Philz69/3ITPCB/Power.xlsx

Part | Max current (mA) | Power draw | Qty | Total Current (mA)
ADS1118 | 0.3 |  | 8 | 2.4
INA250 | 0.3 |  | 18 | 5.4
ADC124S021 | 2.1 |  | 5 | 10.5
LM358 | 2 |  | 5 | 10
 |  |  | Total: | 28.3
