Philz69/3ITPCB/PCB.kicad_pcb

## KiCad design PCB.kicad_pcb (2020-07-17)

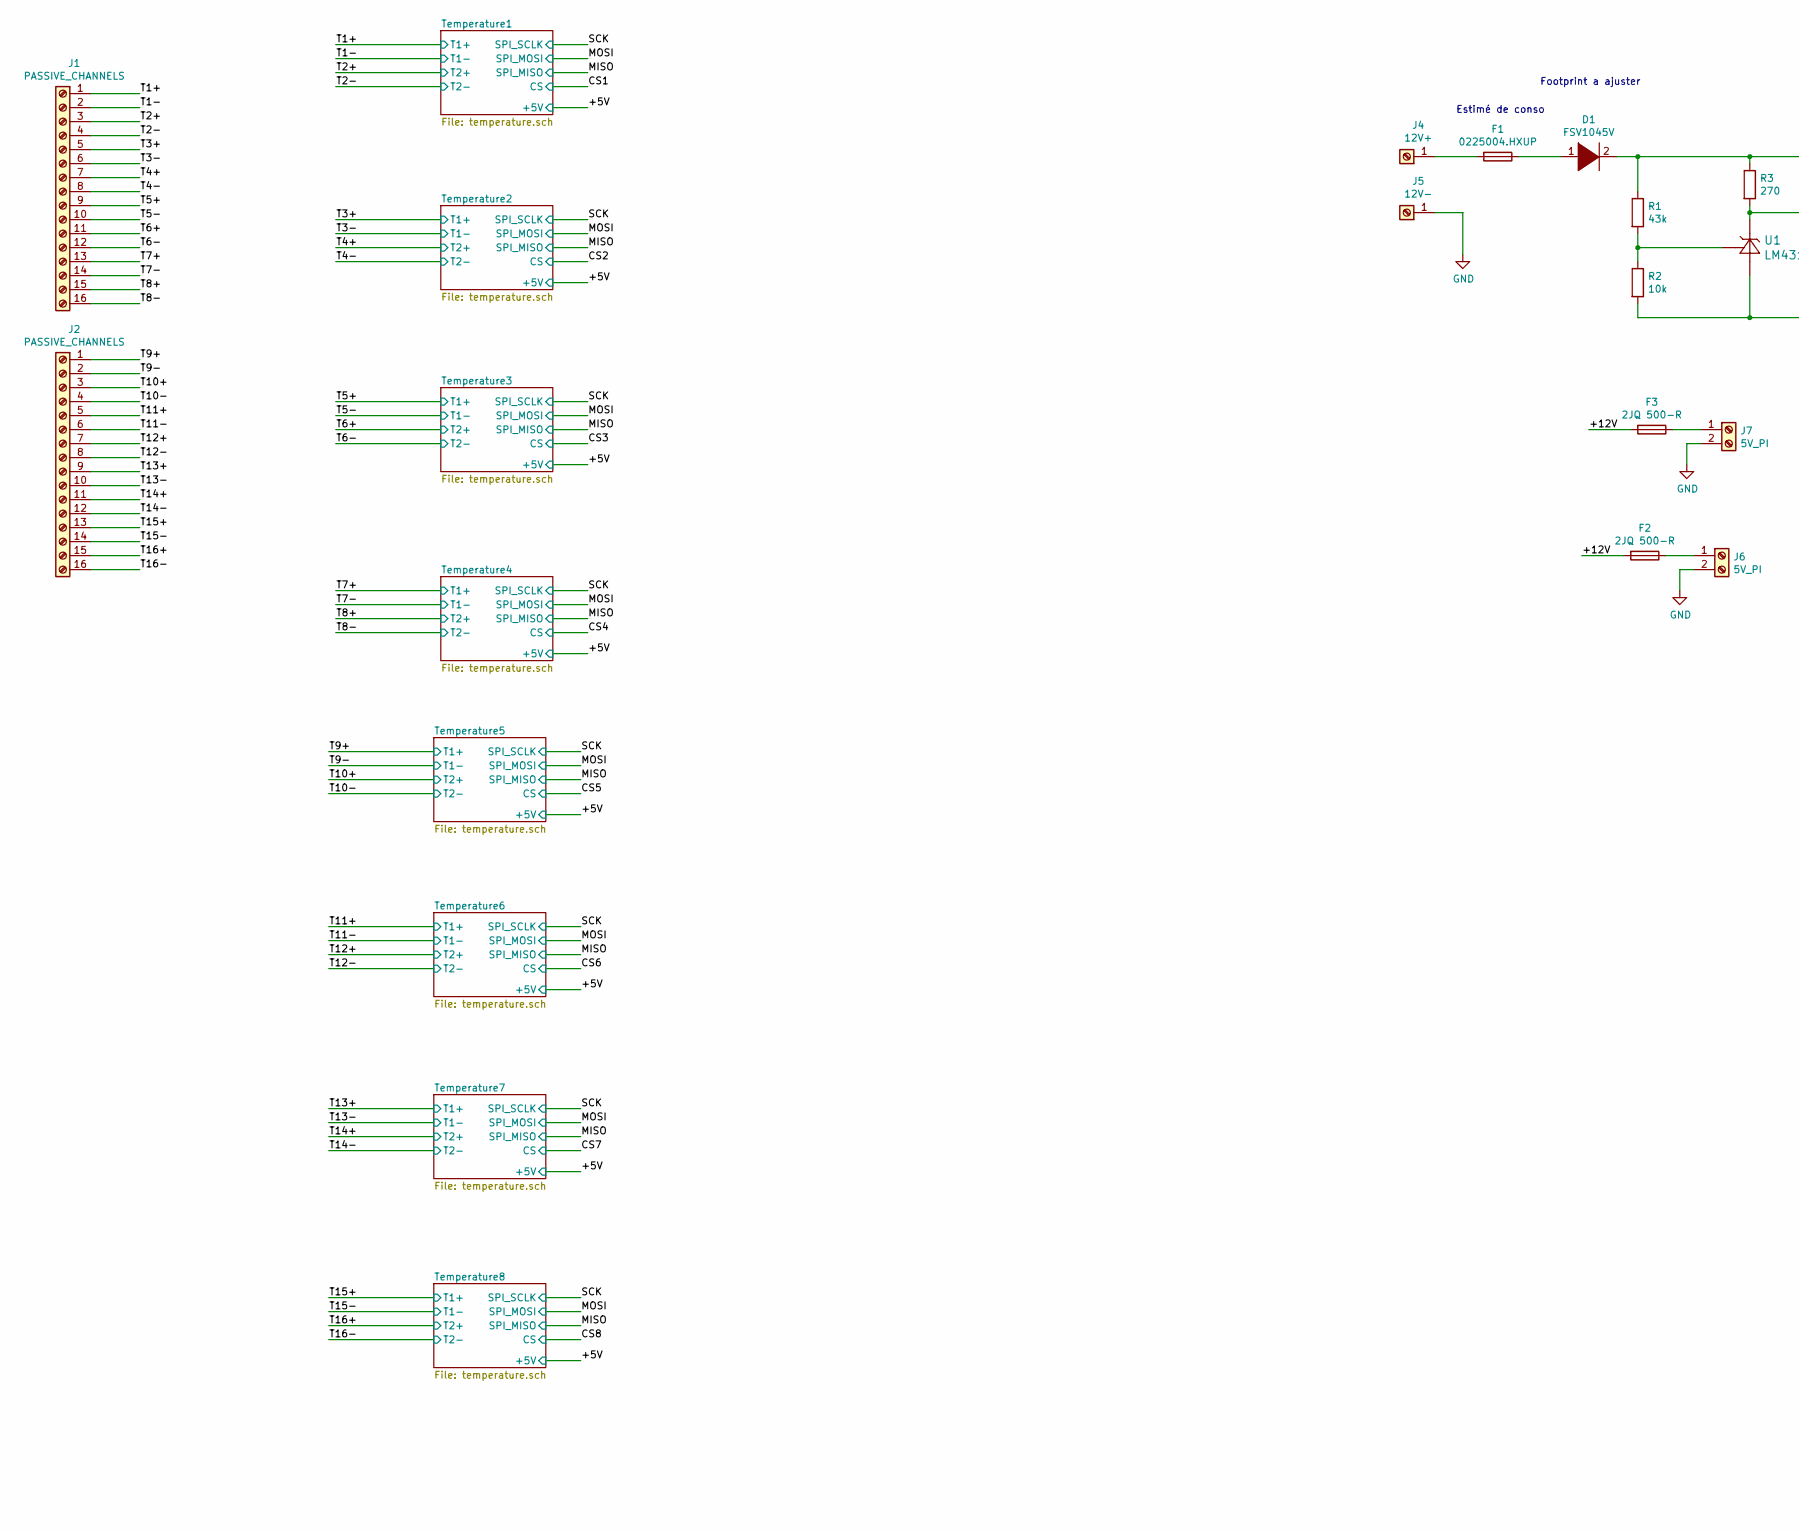
[picture p1: schematic PCB.sch, part in row 1, column 1]

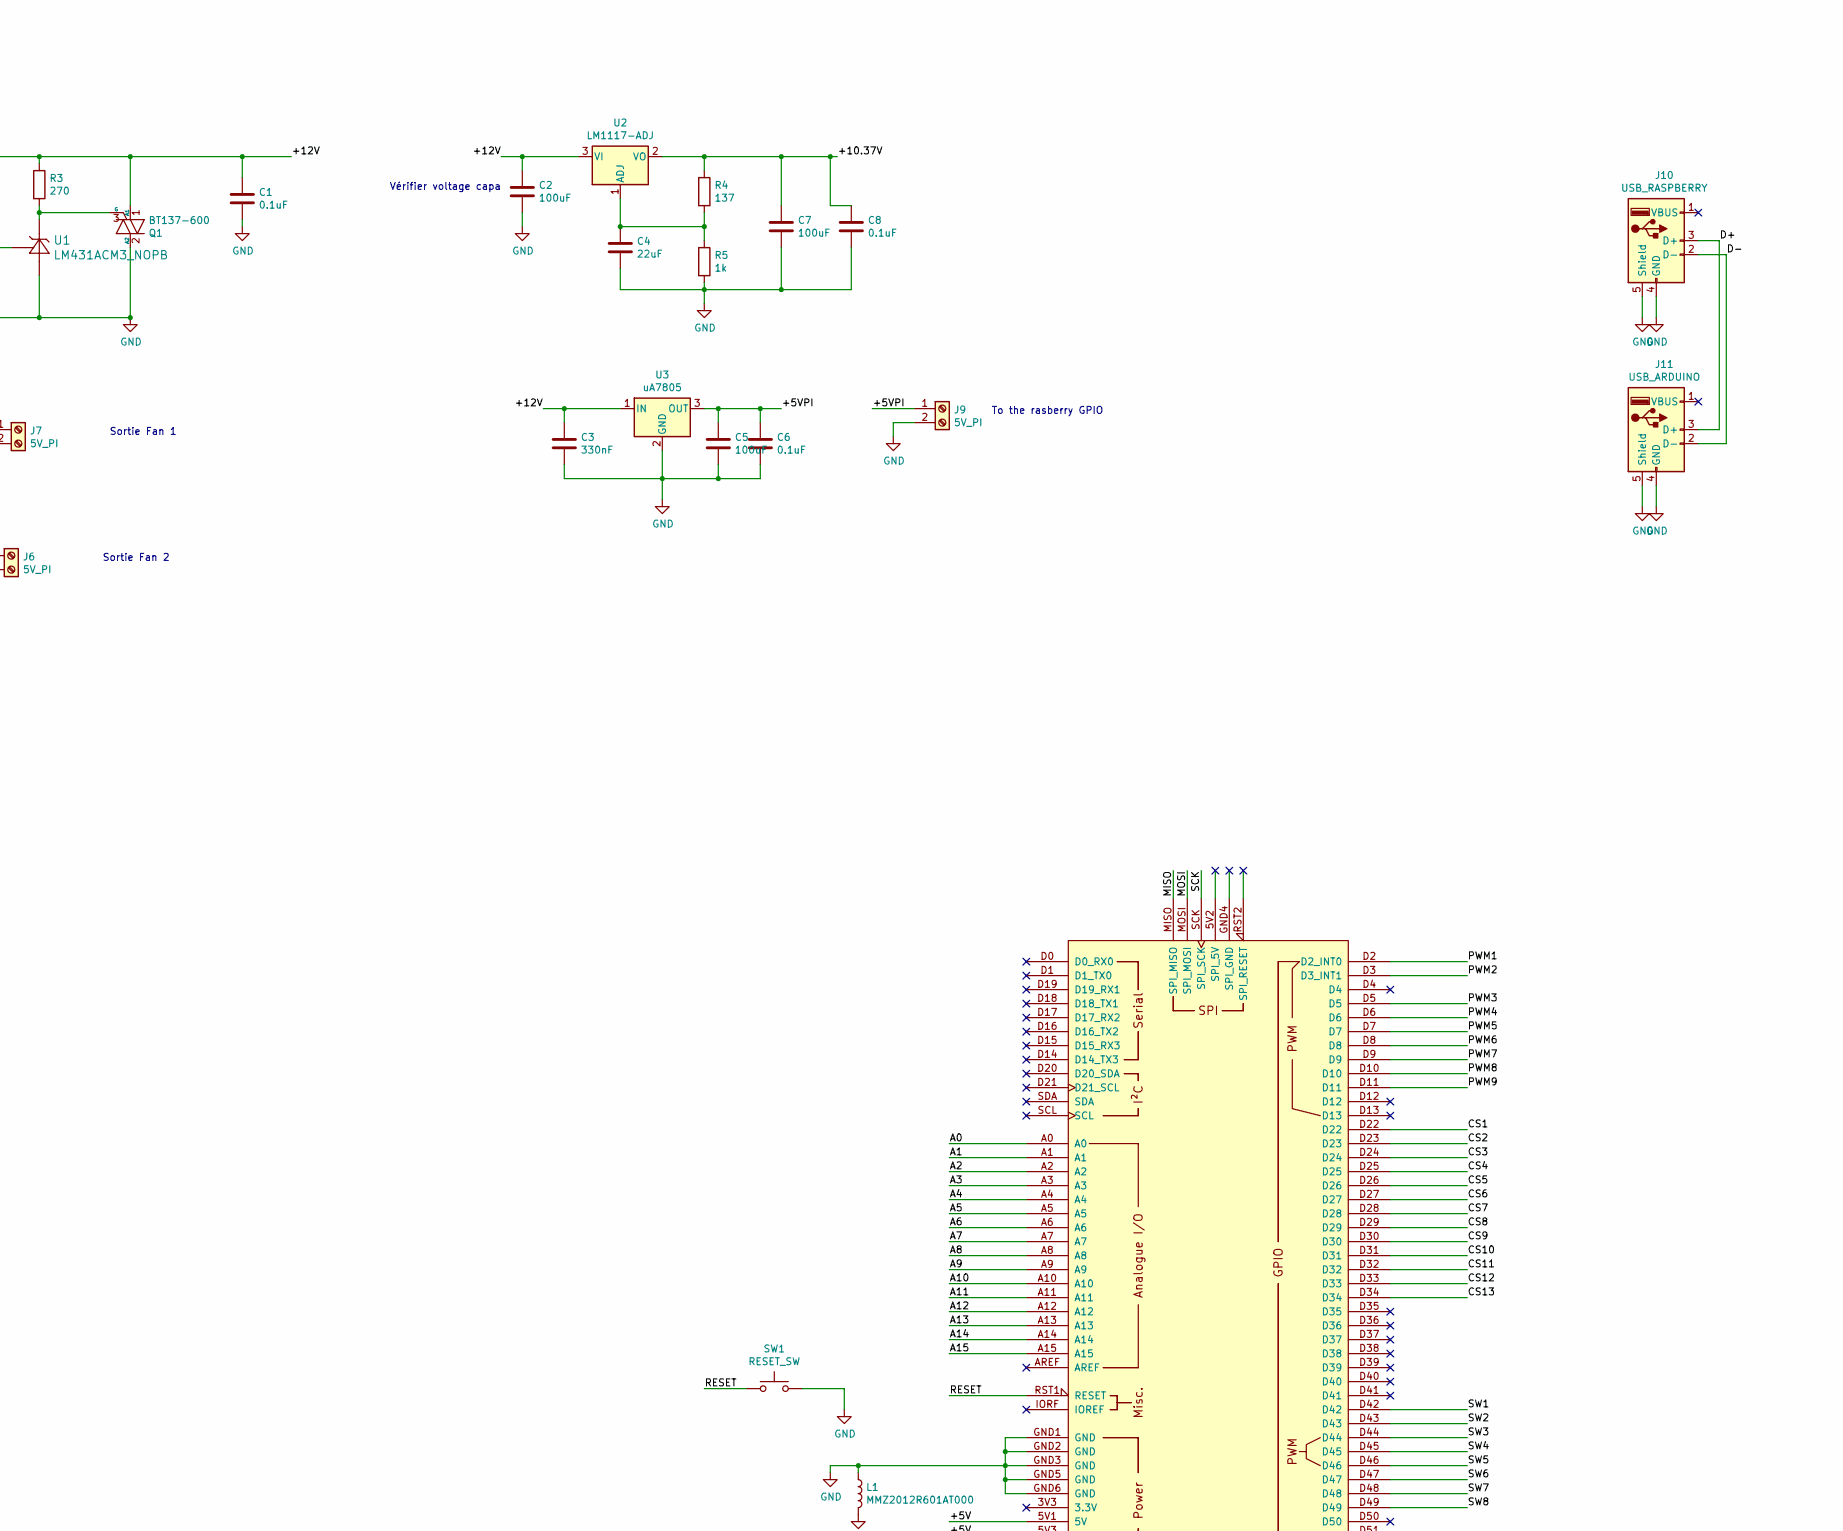
[picture p2: schematic PCB.sch, part in row 1, column 2]

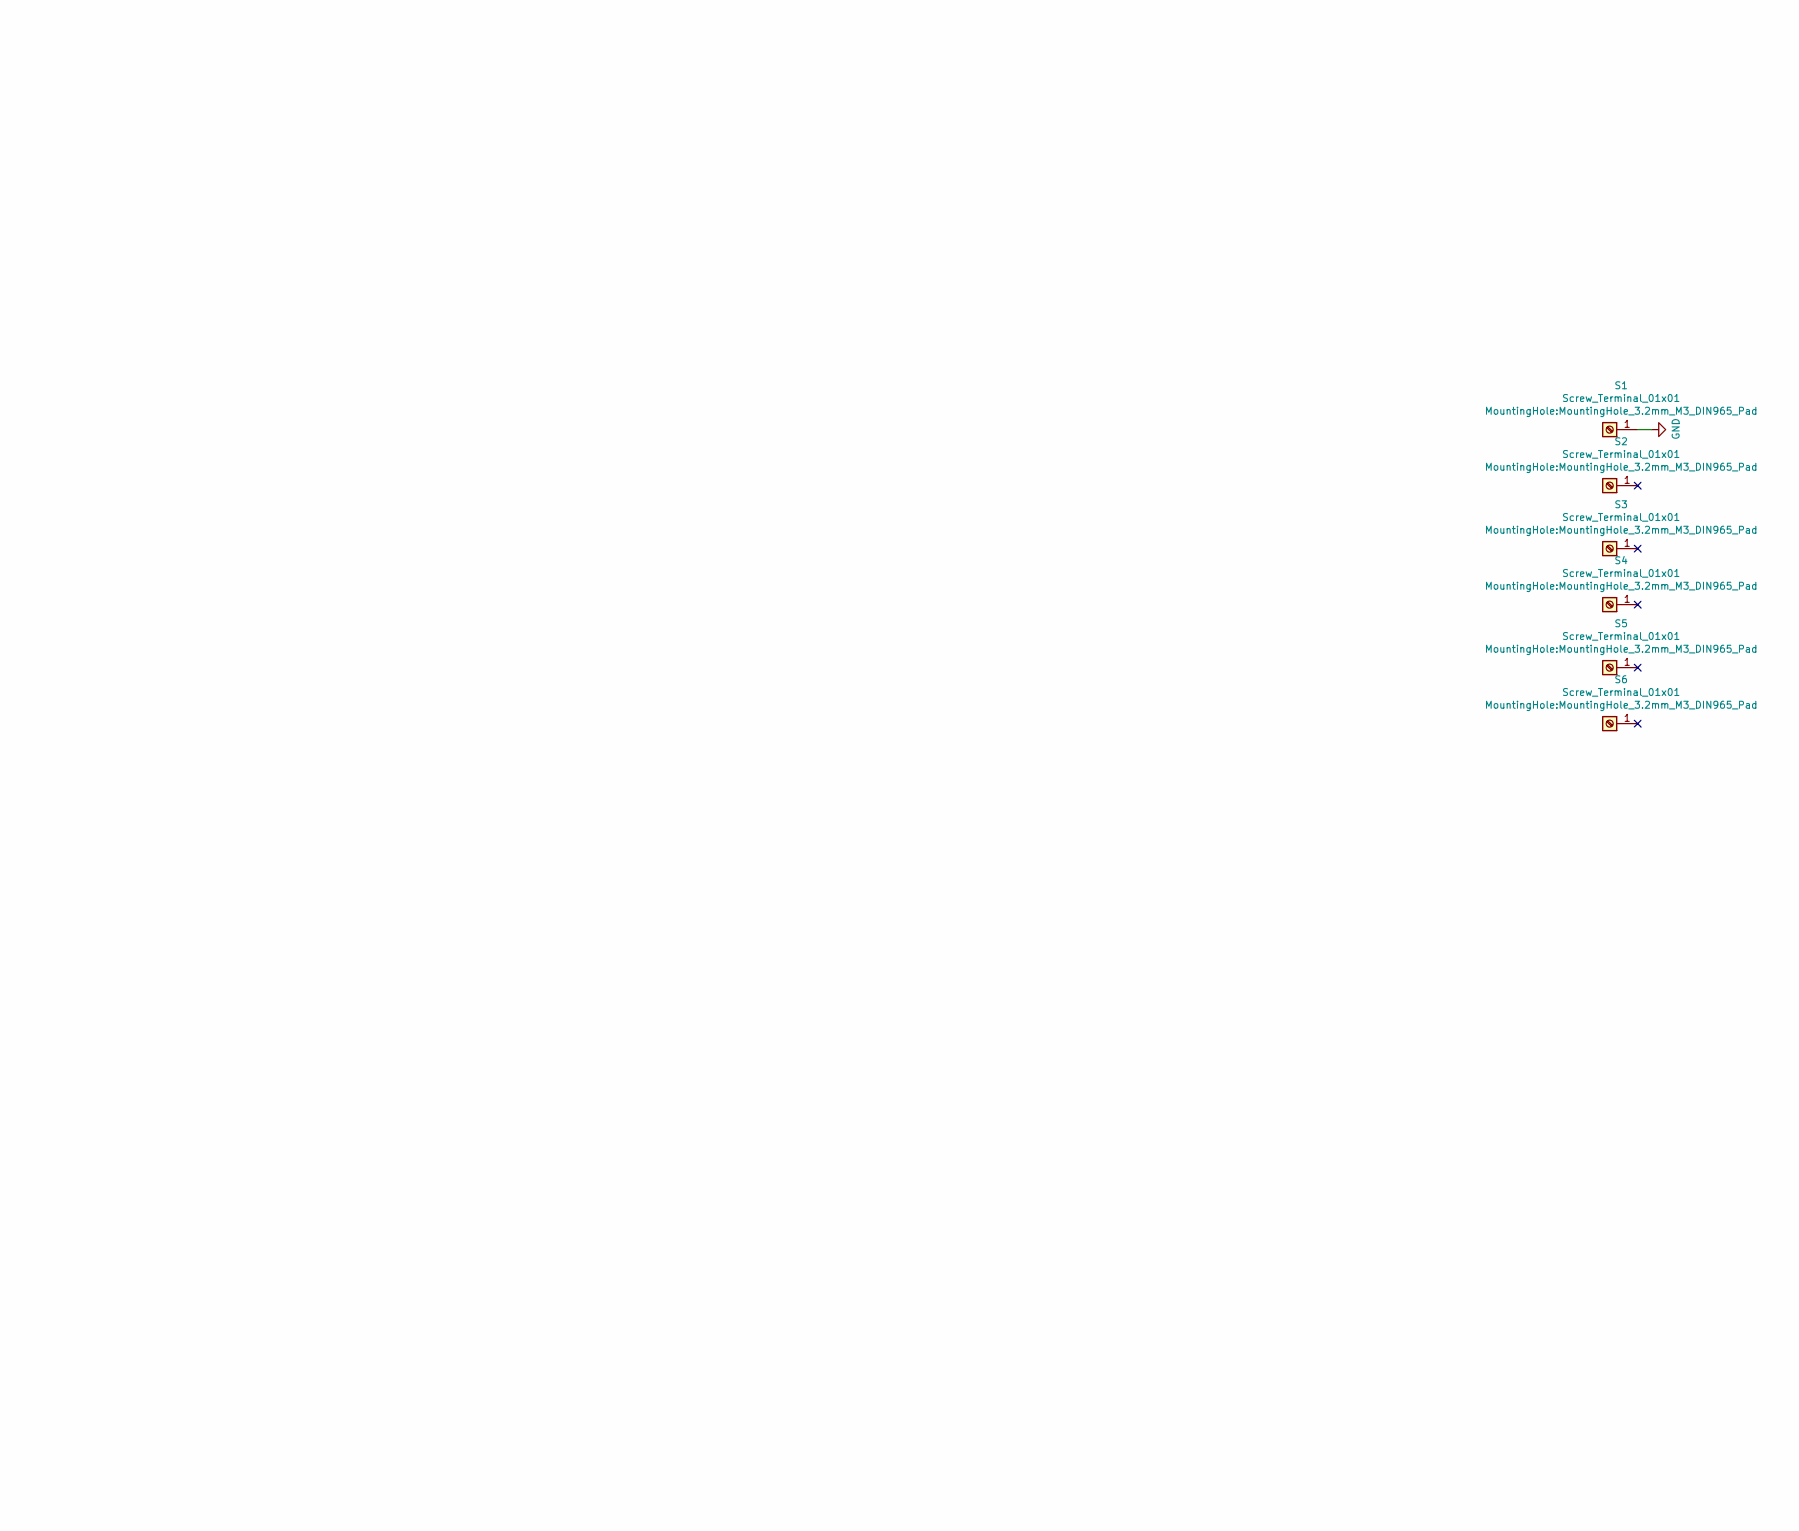
[picture p3: schematic PCB.sch, part in row 1, column 3]

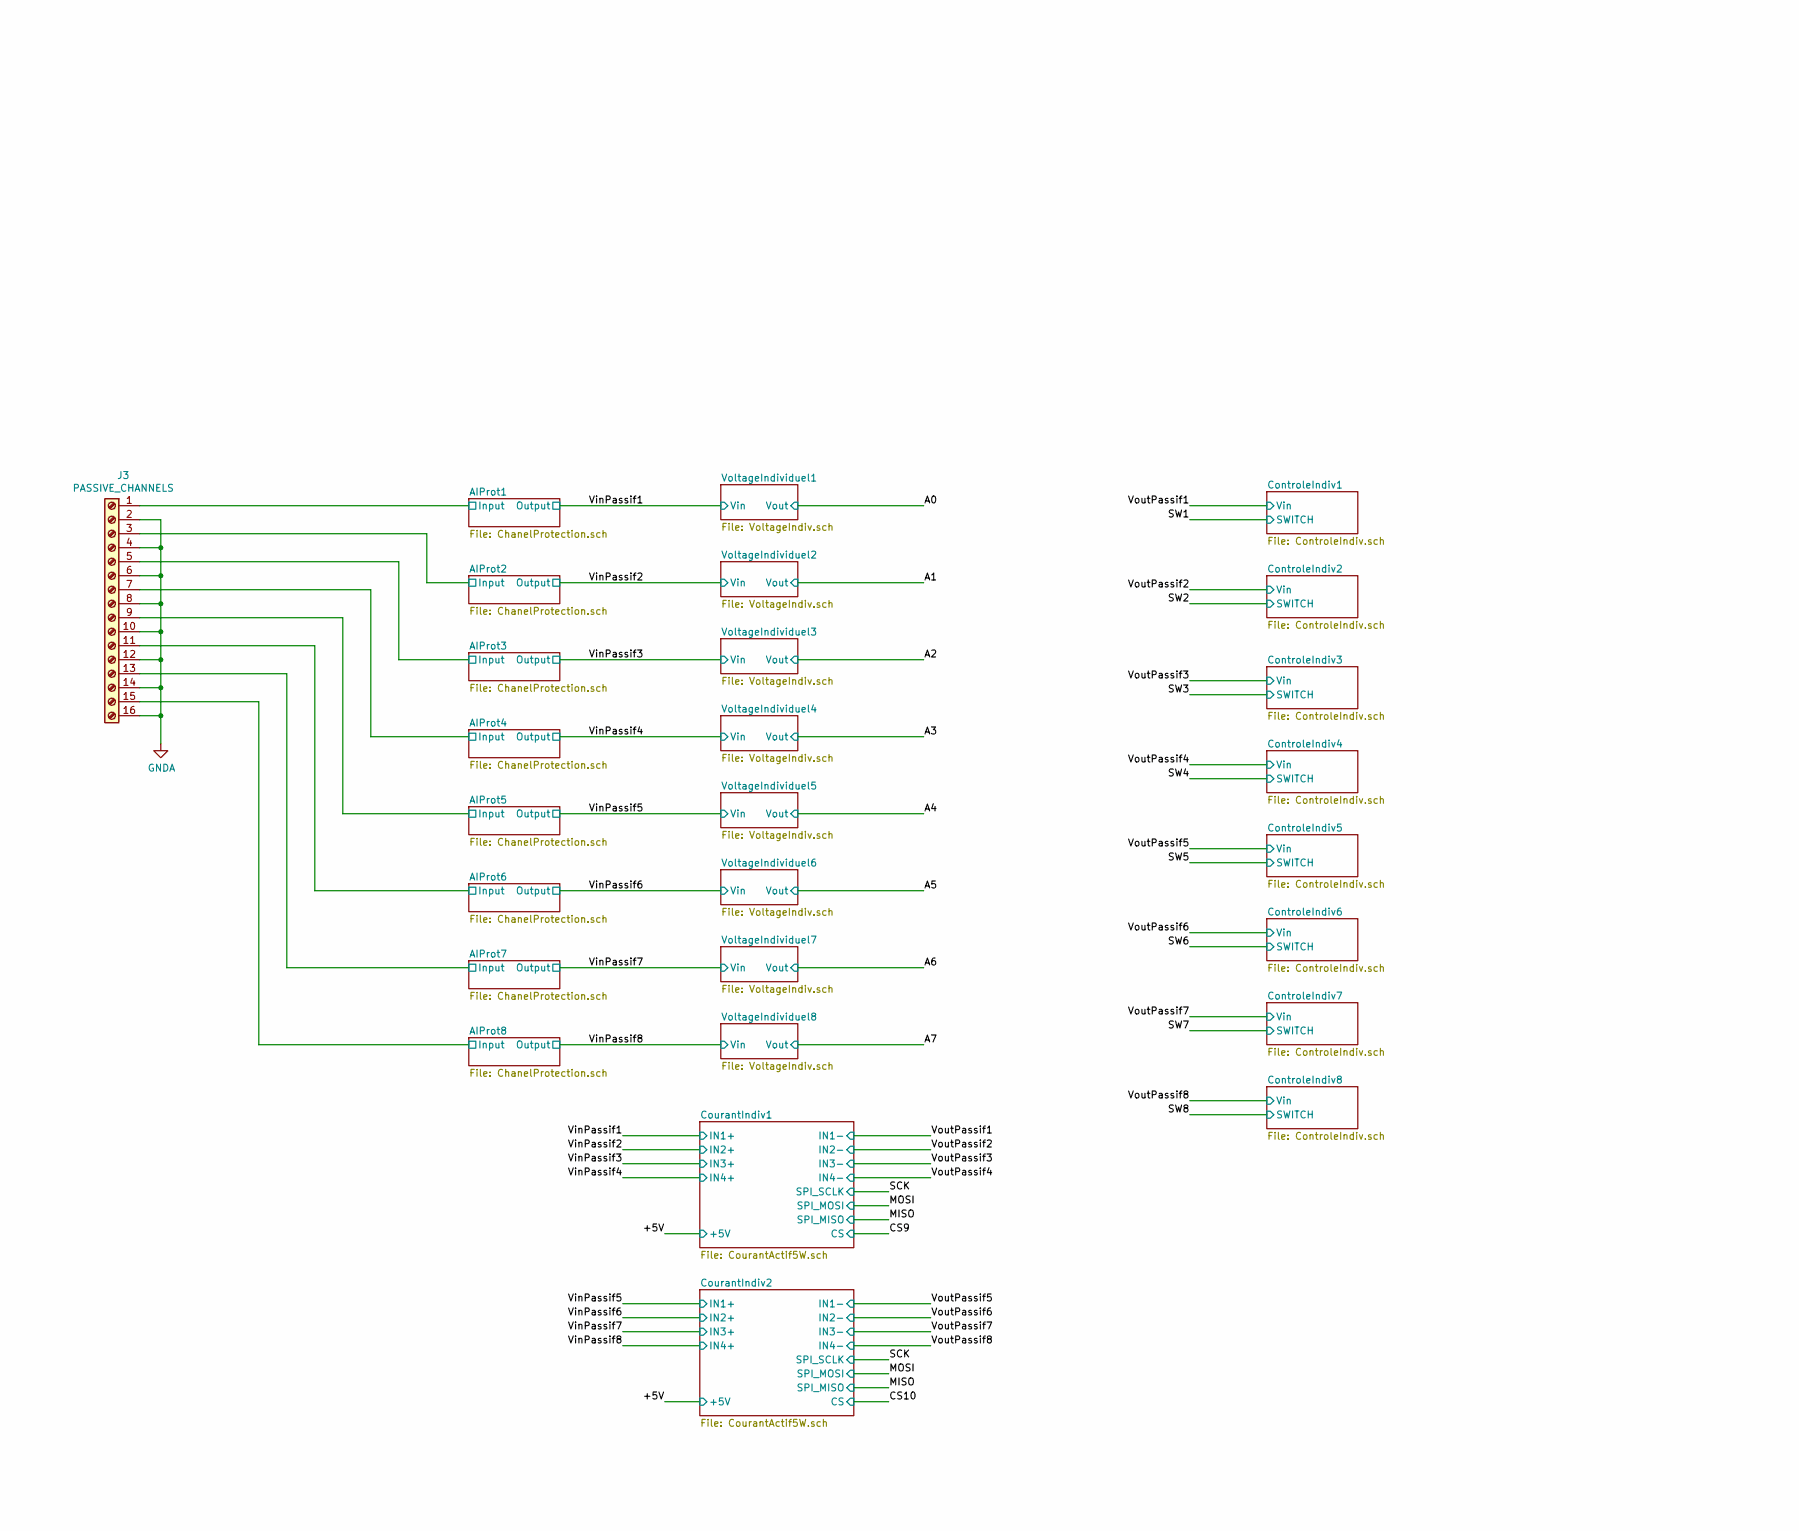
[picture p4: schematic PCB.sch, part in row 2, column 1]

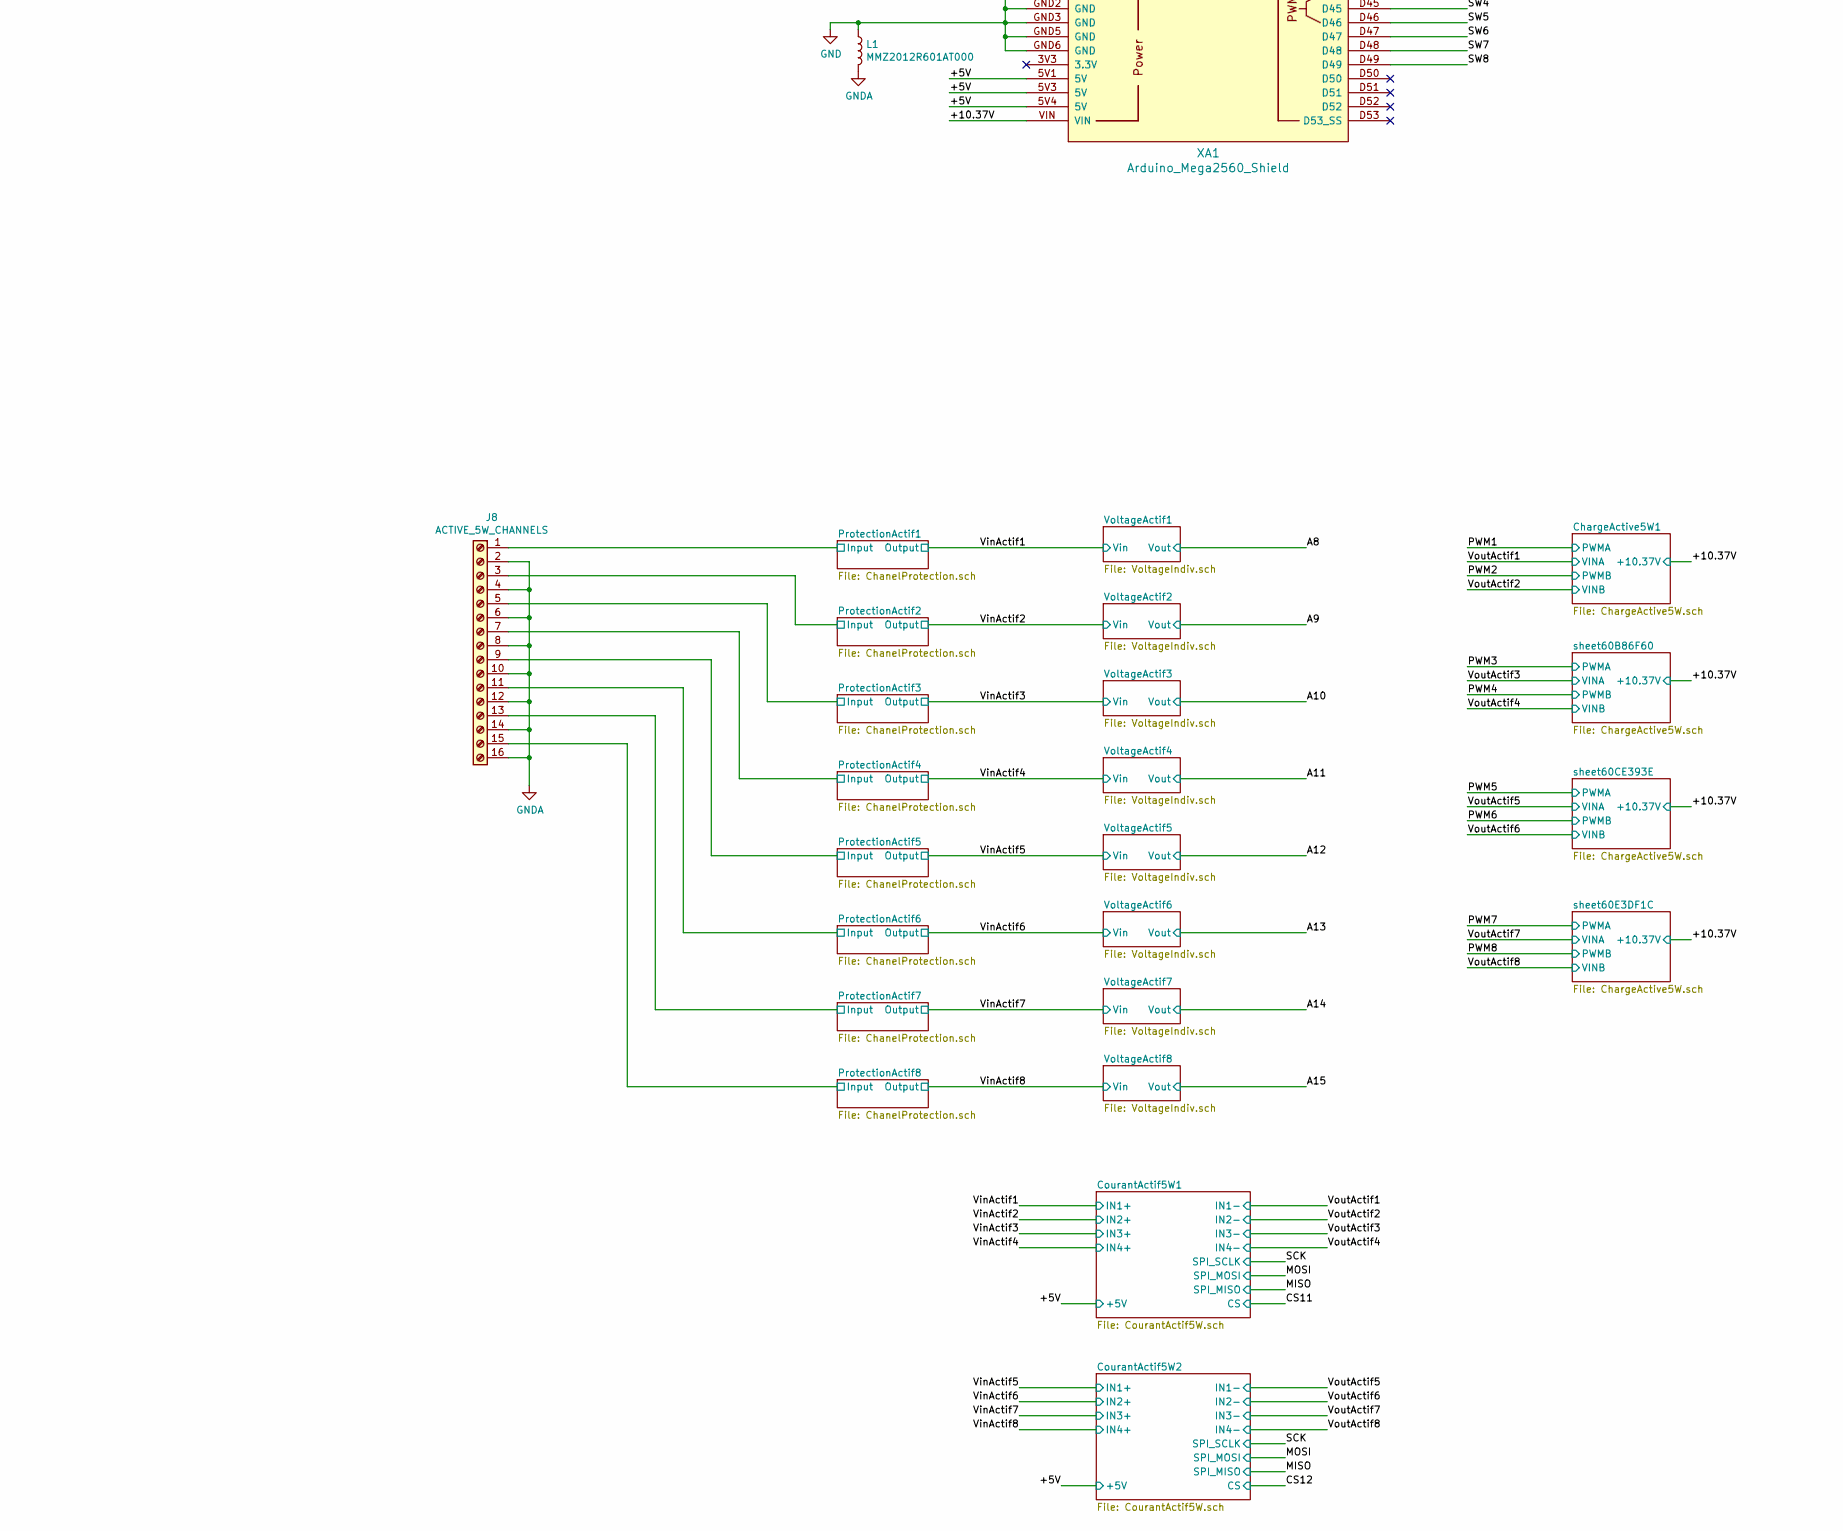
[picture p5: schematic PCB.sch, part in row 2, column 2]

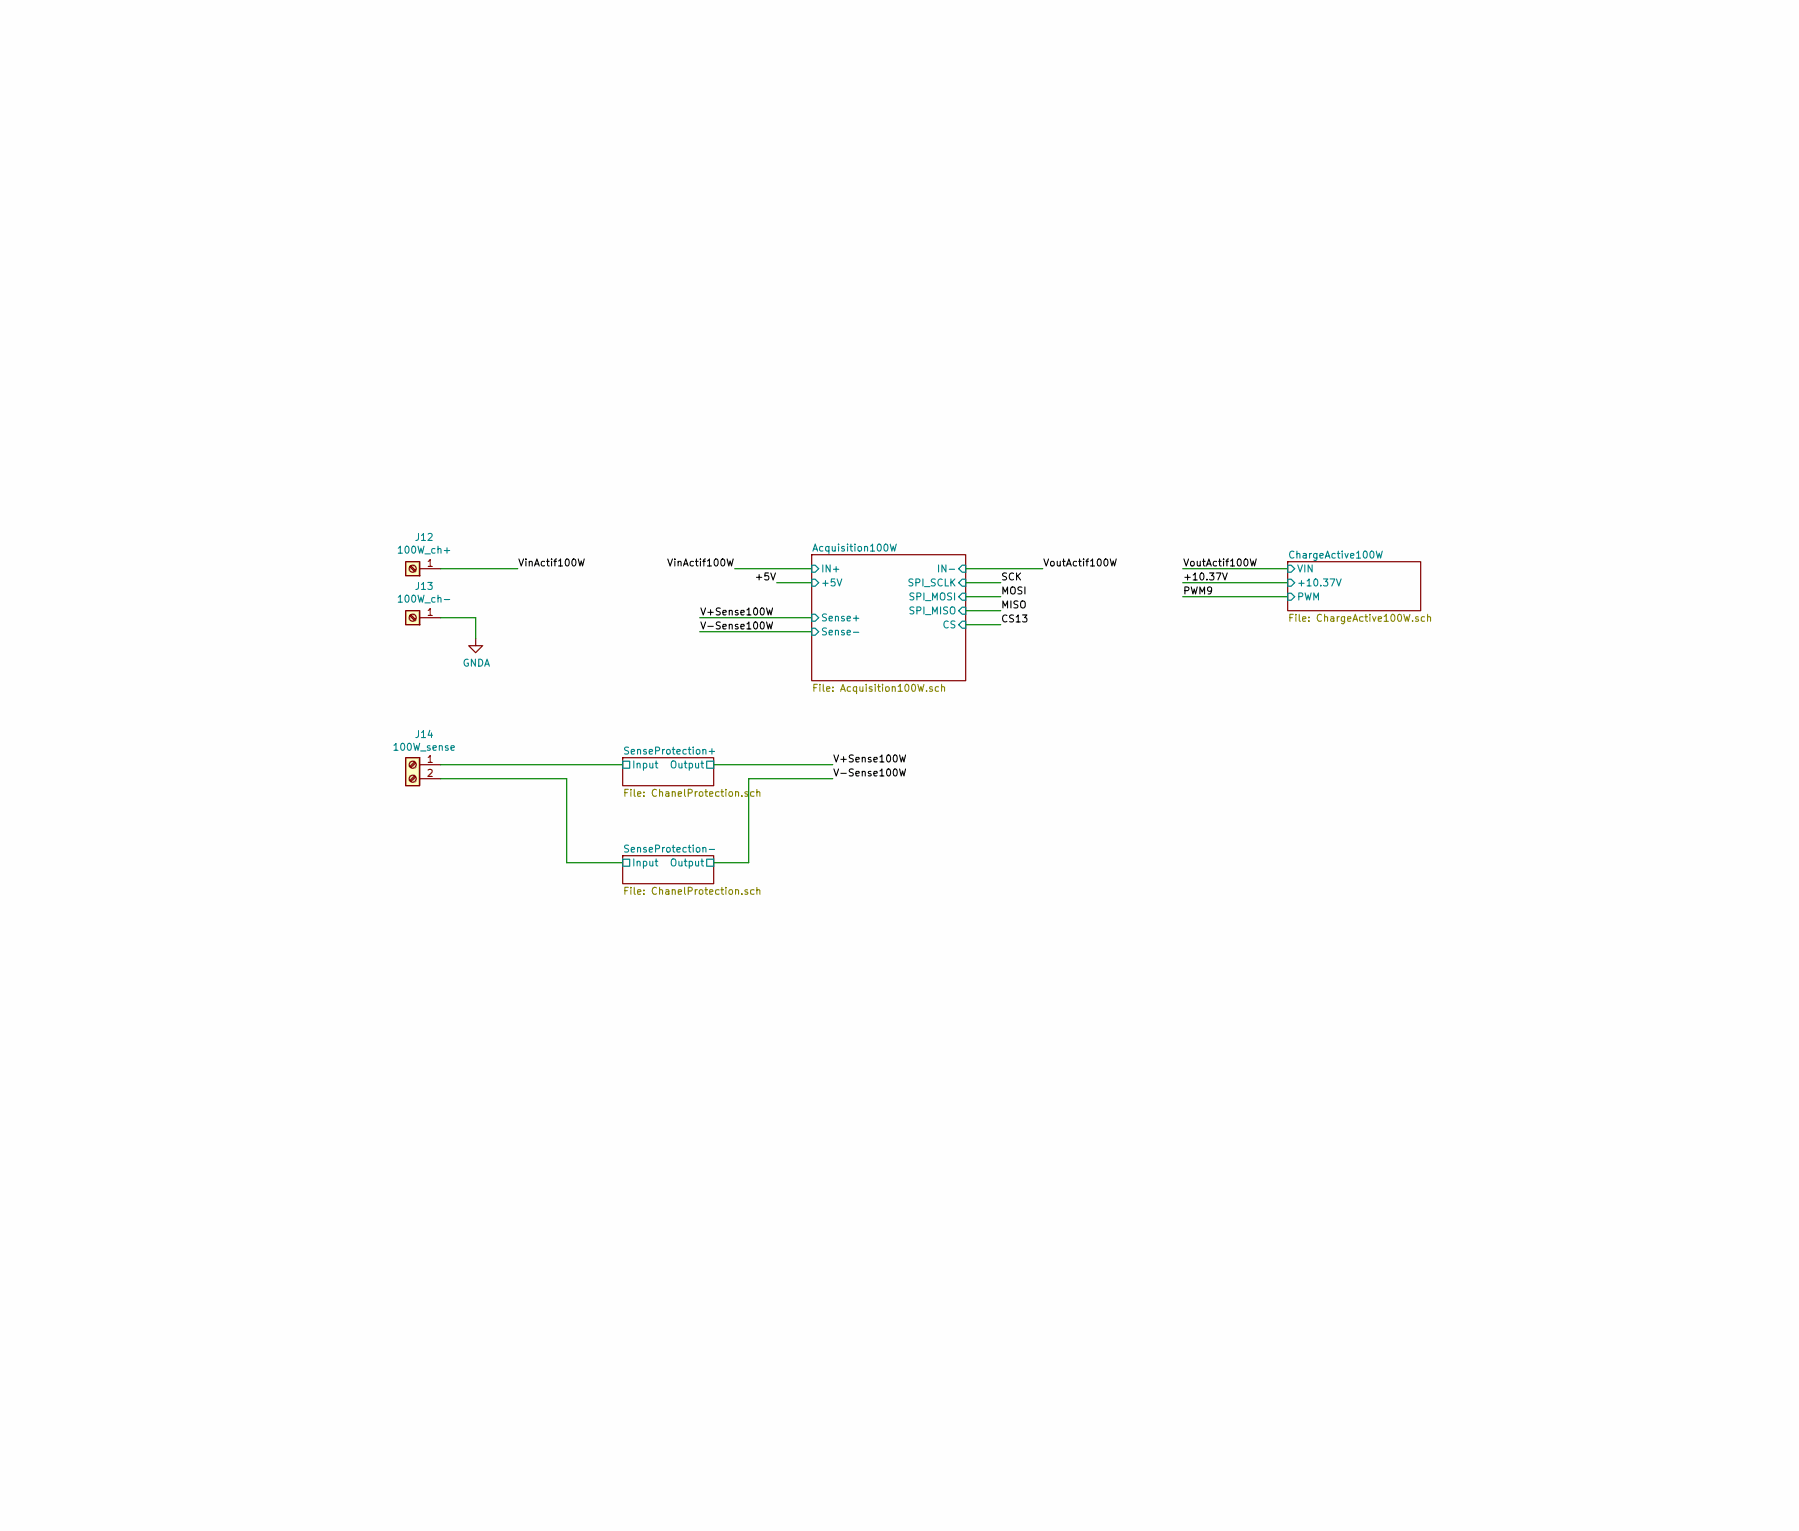
[picture p6: schematic PCB.sch, part in row 2, column 3]

Parts:
C1, C6, C8: 0.1uF; C_0402_1005Metric
C2, C5, C7: 100uF; C_1210_3225Metric
C3: 330nF; C_0603_1608Metric
C4: 22uF; C_0805_2012Metric
D1: FSV1045V; TO-277A
F1: 0225004.HXUP; Fuse5x15mm
F2, F3: 2JQ 500-R; Fuse5x15mm
J1, J2, J3: PASSIVE_CHANNELS; TerminalBlock_Phoenix_PT-1,5-16-5.0-H_1x16_P5.00mm_Horizont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
J4: 12V+; 30ATerminal
J5: 12V-; 30ATerminal
J6, J7, J9: 5V_PI; TerminalBlock_Phoenix_PT-1,5-2-5.0-H_1x02_P5.00mm_Horizontal
J8: ACTIVE_5W_CHANNELS; TerminalBlock_Phoenix_PT-1,5-16-5.0-H_1x16_P5.00mm_Horizont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
J10: USB_RASPBERRY; USB_A_Stewart_SS-52100-001_Horizontal
J11: USB_ARDUINO; USB_A_Stewart_SS-52100-001_Horizontal
J12: 100W_ch+; 30ATerminal
J13: 100W_ch-; 30ATerminal
J14: 100W_sense; TerminalBlock_Phoenix_PT-1,5-2-5.0-H_1x02_P5.00mm_Horizontal
L1: MMZ2012R601AT000; L_0805_2012Metric_Pad1.15x1.40mm_HandSolder
Q1: BT137-600; TO-220-3_Horizontal_TabDown_AccessHole
R1: 43k; R_0603_1608Metric
R2: 10k; R_0603_1608Metric
R3: 270; R_2512_6332Metric
R4: 137; R_1206_3216Metric
R5: 1k; R_1206_3216Metric
S1, S2, S3, S4, S5, S6: Screw_Terminal_01x01; MountingHole_3.2mm_M3_DIN965_Pad
SW1: RESET_SW; SW_SPST_TL3305C
U1: LM431ACM3_NOPB; SOIC-8_3.9x4.9mm_P1.27mm
U2: LM1117-ADJ; TO-220-3_Horizontal_TabDown_AccessHole
U3: uA7805; TO-220-3_Horizontal_TabDown_AccessHole
XA1: Arduino_Mega2560_Shield; Arduino_Mega2560_Socket

Connections:
/+5V: XA1.5V1 (5V), XA1.5V3 (5V), XA1.5V4 (5V); also elsewhere on the board
/+5VPI: C5.1, C6.1, J9.1, U3.3 (OUT)
/+10.37V: C7.1, C8.1, R4.1, U2.2 (VO), XA1.VIN; also elsewhere on the board
/+12V: C1.1, C2.1, C3.1, D1.2 (A), F2.2, F3.2, Q1.1 (A1), R1.1, R3.1, U2.3 (VI), U3.1 (IN)
/A0: XA1.A0; also elsewhere on the board
/A1: XA1.A1; also elsewhere on the board
/A2: XA1.A2; also elsewhere on the board
/A3: XA1.A3; also elsewhere on the board
/A4: XA1.A4; also elsewhere on the board
/A5: XA1.A5; also elsewhere on the board
/A6: XA1.A6; also elsewhere on the board
/A7: XA1.A7; also elsewhere on the board
/A8: XA1.A8; also elsewhere on the board
/A9: XA1.A9; also elsewhere on the board
/A10: XA1.A10; also elsewhere on the board
/A11: XA1.A11; also elsewhere on the board
/A12: XA1.A12; also elsewhere on the board
/A13: XA1.A13; also elsewhere on the board
/A14: XA1.A14; also elsewhere on the board
/A15: XA1.A15; also elsewhere on the board
/AIProt1/Input: J3.1; also elsewhere on the board
/AIProt2/Input: J3.3; also elsewhere on the board
/AIProt3/Input: J3.5; also elsewhere on the board
/AIProt4/Input: J3.7; also elsewhere on the board
/AIProt5/Input: J3.9; also elsewhere on the board
/AIProt6/Input: J3.11; also elsewhere on the board
/AIProt7/Input: J3.13; also elsewhere on the board
/AIProt8/Input: J3.15; also elsewhere on the board
/CS1: XA1.D22; also elsewhere on the board
/CS2: XA1.D23; also elsewhere on the board
/CS3: XA1.D24; also elsewhere on the board
/CS4: XA1.D25; also elsewhere on the board
/CS5: XA1.D26; also elsewhere on the board
/CS6: XA1.D27; also elsewhere on the board
/CS7: XA1.D28; also elsewhere on the board
/CS8: XA1.D29; also elsewhere on the board
/CS9: XA1.D30; also elsewhere on the board
/CS10: XA1.D31; also elsewhere on the board
/CS11: XA1.D32; also elsewhere on the board
/CS12: XA1.D33; also elsewhere on the board
/CS13: XA1.D34; also elsewhere on the board
/D+: J10.3 (D+), J11.3 (D+)
/D-: J10.2 (D-), J11.2 (D-)
/MISO: XA1.MISO (SPI_MISO); also elsewhere on the board
/MOSI: XA1.MOSI (SPI_MOSI); also elsewhere on the board
/PWM1: XA1.D2 (D2_INT0); also elsewhere on the board
/PWM2: XA1.D3 (D3_INT1); also elsewhere on the board
/PWM3: XA1.D5; also elsewhere on the board
/PWM4: XA1.D6; also elsewhere on the board
/PWM5: XA1.D7; also elsewhere on the board
/PWM6: XA1.D8; also elsewhere on the board
/PWM7: XA1.D9; also elsewhere on the board
/PWM8: XA1.D10; also elsewhere on the board
/PWM9: XA1.D11; also elsewhere on the board
/ProtectionActif1/Input: J8.1; also elsewhere on the board
/ProtectionActif2/Input: J8.3; also elsewhere on the board
/ProtectionActif3/Input: J8.5; also elsewhere on the board
/ProtectionActif4/Input: J8.7; also elsewhere on the board
/ProtectionActif5/Input: J8.9; also elsewhere on the board
/ProtectionActif6/Input: J8.11; also elsewhere on the board
/ProtectionActif7/Input: J8.13; also elsewhere on the board
/ProtectionActif8/Input: J8.15; also elsewhere on the board
/RESET: SW1.1, XA1.RST1 (RESET)
/SCK: XA1.SCK (SPI_SCK); also elsewhere on the board
/SW1: XA1.D42; also elsewhere on the board
/SW2: XA1.D43; also elsewhere on the board
/SW3: XA1.D44; also elsewhere on the board
/SW4: XA1.D45; also elsewhere on the board
/SW5: XA1.D46; also elsewhere on the board
/SW6: XA1.D47; also elsewhere on the board
/SW7: XA1.D48; also elsewhere on the board
/SW8: XA1.D49; also elsewhere on the board
/SenseProtection+/Input: J14.1; also elsewhere on the board
/SenseProtection-/Input: J14.2; also elsewhere on the board
/T1+: J1.1; also elsewhere on the board
/T1-: J1.2; also elsewhere on the board
/T2+: J1.3; also elsewhere on the board
/T2-: J1.4; also elsewhere on the board
/T3+: J1.5; also elsewhere on the board
/T3-: J1.6; also elsewhere on the board
/T4+: J1.7; also elsewhere on the board
/T4-: J1.8; also elsewhere on the board
/T5+: J1.9; also elsewhere on the board
/T5-: J1.10; also elsewhere on the board
/T6+: J1.11; also elsewhere on the board
/T6-: J1.12; also elsewhere on the board
/T7+: J1.13; also elsewhere on the board
/T7-: J1.14; also elsewhere on the board
/T8+: J1.15; also elsewhere on the board
/T8-: J1.16; also elsewhere on the board
/T9+: J2.1; also elsewhere on the board
/T9-: J2.2; also elsewhere on the board
/T10+: J2.3; also elsewhere on the board
/T10-: J2.4; also elsewhere on the board
/T11+: J2.5; also elsewhere on the board
/T11-: J2.6; also elsewhere on the board
/T12+: J2.7; also elsewhere on the board
/T12-: J2.8; also elsewhere on the board
/T13+: J2.9; also elsewhere on the board
/T13-: J2.10; also elsewhere on the board
/T14+: J2.11; also elsewhere on the board
/T14-: J2.12; also elsewhere on the board
/T15+: J2.13; also elsewhere on the board
/T15-: J2.14; also elsewhere on the board
/T16+: J2.15; also elsewhere on the board
/T16-: J2.16; also elsewhere on the board
/VinActif100W: J12.1; also elsewhere on the board
GND: C1.2, C2.2, C3.2, C4.2, C5.2, C6.2, C7.2, C8.2, J5.1, J6.2, J7.2, J9.2, J10.4 (GND), J10.5 (Shield), J11.4 (GND), J11.5 (Shield), L1.1, Q1.2 (A2), R2.2, R5.2, S1.1, SW1.2, U1.3 (A), U3.2 (GND), XA1.GND1 (GND), XA1.GND2 (GND), XA1.GND3 (GND), XA1.GND5 (GND), XA1.GND6 (GND); also elsewhere on the board
GNDA: J3.2, J3.4, J3.6, J3.8, J3.10, J3.12, J3.14, J3.16, J8.2, J8.4, J8.6, J8.8, J8.10, J8.12, J8.14, J8.16, J13.1, L1.2; also elsewhere on the board
unnamed: C4.1, R4.2, R5.1, U2.1 (ADJ)
unnamed: D1.1 (K), F1.1
unnamed: F1.2, J4.1
unnamed: F2.1, J6.1
unnamed: F3.1, J7.1
unnamed: Q1.3 (G), R3.2, U1.1 (K)
unnamed: R1.2, R2.1, U1.2 (REF)

Notes on the sheet:
Sortie Fan 1
Sortie Fan 2
Footprint a ajuster
Estimé de conso
Vérifier voltage capa
To the rasberry GPIO
