Philz69/3ITPCB/PCB.kicad_pcb

## KiCad design PCB.kicad_pcb (continued)

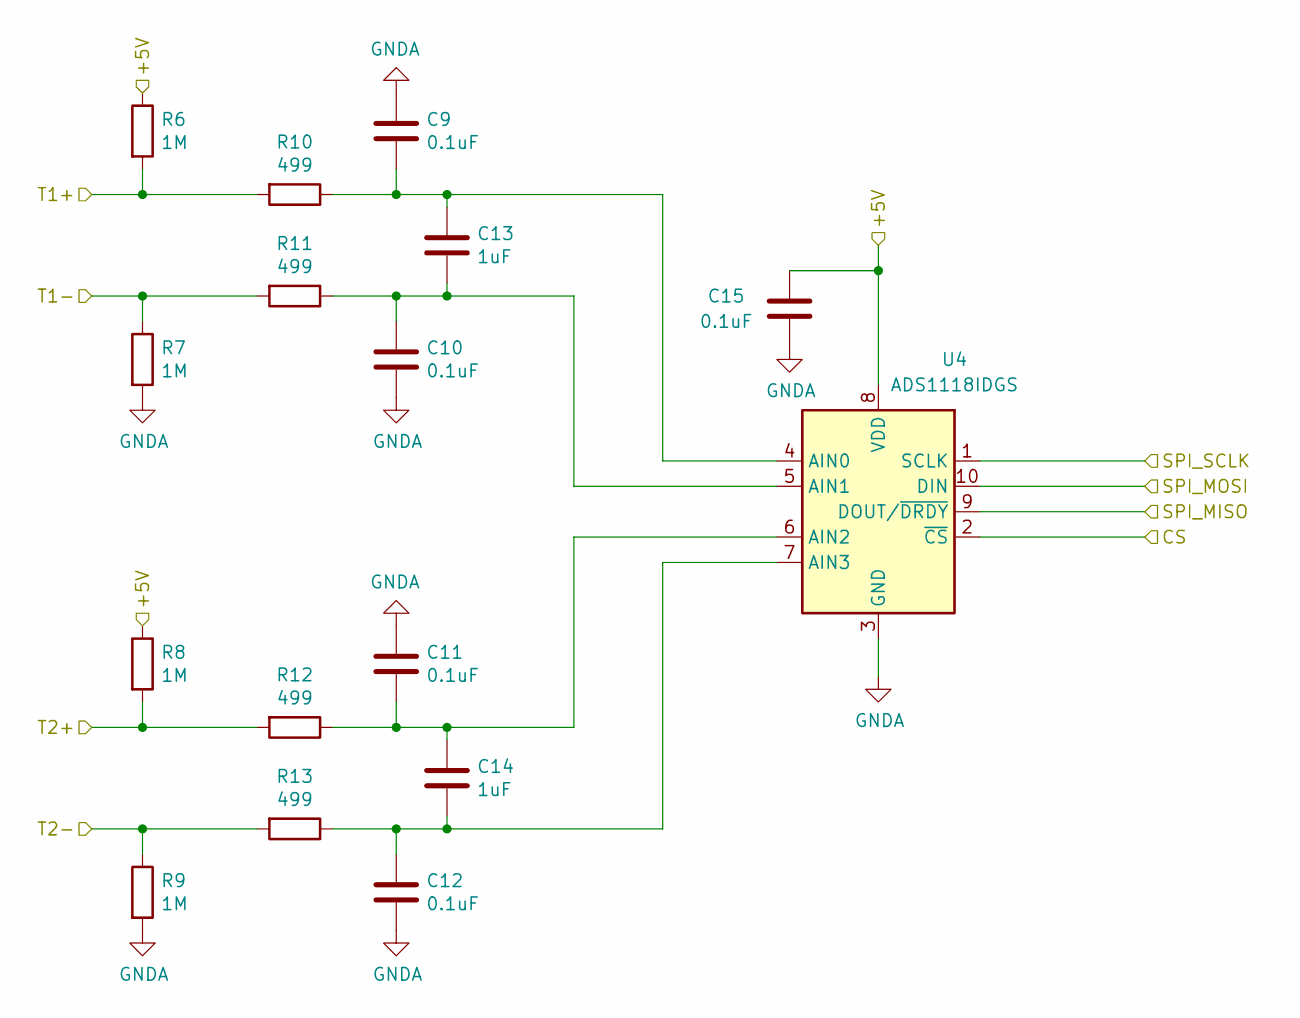
[picture p7: schematic temperature.sch, Acquisiton température]

Parts:
C9, C10, C11, C12, C15: 0.1uF; C_0402_1005Metric
C13, C14: 1uF; C_0402_1005Metric
R6, R7, R8, R9: 1M; R_0805_2012Metric
R10, R11, R12, R13: 499; R_0603_1608Metric
U4: ADS1118IDGS; VSSOP-10_3x3mm_P0.5mm

Connections:
/+5V: C15.2, R6.1, R8.1, U4.8 (VDD); also elsewhere on the board
/CS1: U4.2 (~CS); also elsewhere on the board
/MISO: U4.9 (DOUT/~DRDY); also elsewhere on the board
/MOSI: U4.10 (DIN); also elsewhere on the board
/SCK: U4.1 (SCLK); also elsewhere on the board
/T1+: R6.2, R10.2; also elsewhere on the board
/T1-: R7.1, R11.2; also elsewhere on the board
/T2+: R8.2, R12.2; also elsewhere on the board
/T2-: R9.1, R13.2; also elsewhere on the board
GNDA: C9.2, C10.2, C11.2, C12.2, C15.1, R7.2, R9.2, U4.3 (GND); also elsewhere on the board
unnamed: C10.1, C13.2, R11.1, U4.5 (AIN1)
unnamed: C11.1, C14.1, R12.1, U4.6 (AIN2)
unnamed: C12.1, C14.2, R13.1, U4.7 (AIN3)
unnamed: C9.1, C13.1, R10.1, U4.4 (AIN0)

Parts of its further copies:
C16, C17, C18, C19, C22, C23, C24, C25, C26, C29, C30, C31, C32, C33, C36, C71, C72, C73, C74, C77, C78, C79, C80, C81, C84, C85, C86, C87, C88, C91, C92, C93, C94, C95, C98: 0.1uF; C_0402_1005Metric
C20, C21, C27, C28, C34, C35, C75, C76, C82, C83, C89, C90, C96, C97: 1uF; C_0402_1005Metric
R14, R15, R16, R17, R22, R23, R24, R25, R30, R31, R32, R33, R94, R95, R96, R97, R102, R103, R104, R105, R110, R111, R112, R113, R118, R119, R120, R121: 1M; R_0805_2012Metric
R18, R19, R20, R21, R26, R27, R28, R29, R34, R35, R36, R37, R98, R99, R100, R101, R106, R107, R108, R109, R114, R115, R116, R117, R122, R123, R124, R125: 499; R_0603_1608Metric
U5, U6, U7, U32, U33, U34, U35: ADS1118IDGS; VSSOP-10_3x3mm_P0.5mm

Connections of its further copies:
/+5V: C22.2, C29.2, C36.2, C77.2, C84.2, C91.2, C98.2, R14.1, R16.1, R22.1, R24.1, R30.1, R32.1, R94.1, R96.1, R102.1, R104.1, R110.1, R112.1, R118.1, R120.1, U5.8 (VDD), U6.8 (VDD), U7.8 (VDD), U32.8 (VDD), U33.8 (VDD), U34.8 (VDD), U35.8 (VDD); also elsewhere on the board
/CS2: U5.2 (~CS); also elsewhere on the board
/CS3: U6.2 (~CS); also elsewhere on the board
/CS4: U7.2 (~CS); also elsewhere on the board
/CS5: U32.2 (~CS); also elsewhere on the board
/CS6: U33.2 (~CS); also elsewhere on the board
/CS7: U34.2 (~CS); also elsewhere on the board
/CS8: U35.2 (~CS); also elsewhere on the board
/MISO: U5.9 (DOUT/~DRDY), U6.9 (DOUT/~DRDY), U7.9 (DOUT/~DRDY), U32.9 (DOUT/~DRDY), U33.9 (DOUT/~DRDY), U34.9 (DOUT/~DRDY), U35.9 (DOUT/~DRDY); also elsewhere on the board
/MOSI: U5.10 (DIN), U6.10 (DIN), U7.10 (DIN), U32.10 (DIN), U33.10 (DIN), U34.10 (DIN), U35.10 (DIN); also elsewhere on the board
/SCK: U5.1 (SCLK), U6.1 (SCLK), U7.1 (SCLK), U32.1 (SCLK), U33.1 (SCLK), U34.1 (SCLK), U35.1 (SCLK); also elsewhere on the board
/T3+: R14.2, R18.2; also elsewhere on the board
/T3-: R15.1, R19.2; also elsewhere on the board
/T4+: R16.2, R20.2; also elsewhere on the board
/T4-: R17.1, R21.2; also elsewhere on the board
/T5+: R22.2, R26.2; also elsewhere on the board
/T5-: R23.1, R27.2; also elsewhere on the board
/T6+: R24.2, R28.2; also elsewhere on the board
/T6-: R25.1, R29.2; also elsewhere on the board
/T7+: R30.2, R34.2; also elsewhere on the board
/T7-: R31.1, R35.2; also elsewhere on the board
/T8+: R32.2, R36.2; also elsewhere on the board
/T8-: R33.1, R37.2; also elsewhere on the board
/T9+: R94.2, R98.2; also elsewhere on the board
/T9-: R95.1, R99.2; also elsewhere on the board
/T10+: R96.2, R100.2; also elsewhere on the board
/T10-: R97.1, R101.2; also elsewhere on the board
/T11+: R102.2, R106.2; also elsewhere on the board
/T11-: R103.1, R107.2; also elsewhere on the board
/T12+: R104.2, R108.2; also elsewhere on the board
/T12-: R105.1, R109.2; also elsewhere on the board
/T13+: R110.2, R114.2; also elsewhere on the board
/T13-: R111.1, R115.2; also elsewhere on the board
/T14+: R112.2, R116.2; also elsewhere on the board
/T14-: R113.1, R117.2; also elsewhere on the board
/T15+: R118.2, R122.2; also elsewhere on the board
/T15-: R119.1, R123.2; also elsewhere on the board
/T16+: R120.2, R124.2; also elsewhere on the board
/T16-: R121.1, R125.2; also elsewhere on the board
GNDA: C16.2, C17.2, C18.2, C19.2, C22.1, C23.2, C24.2, C25.2, C26.2, C29.1, C30.2, C31.2, C32.2, C33.2, C36.1, C71.2, C72.2, C73.2, C74.2, C77.1, C78.2, C79.2, C80.2, C81.2, C84.1, C85.2, C86.2, C87.2, C88.2, C91.1, C92.2, C93.2, C94.2, C95.2, C98.1, R15.2, R17.2, R23.2, R25.2, R31.2, R33.2, R95.2, R97.2, R103.2, R105.2, R111.2, R113.2, R119.2, R121.2, U5.3 (GND), U6.3 (GND), U7.3 (GND), U32.3 (GND), U33.3 (GND), U34.3 (GND), U35.3 (GND); also elsewhere on the board
unnamed: C16.1, C20.1, R18.1, U5.4 (AIN0)
unnamed: C17.1, C20.2, R19.1, U5.5 (AIN1)
unnamed: C18.1, C21.1, R20.1, U5.6 (AIN2)
unnamed: C19.1, C21.2, R21.1, U5.7 (AIN3)
unnamed: C23.1, C27.1, R26.1, U6.4 (AIN0)
unnamed: C24.1, C27.2, R27.1, U6.5 (AIN1)
unnamed: C25.1, C28.1, R28.1, U6.6 (AIN2)
unnamed: C26.1, C28.2, R29.1, U6.7 (AIN3)
unnamed: C30.1, C34.1, R34.1, U7.4 (AIN0)
unnamed: C31.1, C34.2, R35.1, U7.5 (AIN1)
unnamed: C32.1, C35.1, R36.1, U7.6 (AIN2)
unnamed: C33.1, C35.2, R37.1, U7.7 (AIN3)
unnamed: C71.1, C75.1, R98.1, U32.4 (AIN0)
unnamed: C72.1, C75.2, R99.1, U32.5 (AIN1)
unnamed: C73.1, C76.1, R100.1, U32.6 (AIN2)
unnamed: C74.1, C76.2, R101.1, U32.7 (AIN3)
unnamed: C78.1, C82.1, R106.1, U33.4 (AIN0)
unnamed: C79.1, C82.2, R107.1, U33.5 (AIN1)
unnamed: C80.1, C83.1, R108.1, U33.6 (AIN2)
unnamed: C81.1, C83.2, R109.1, U33.7 (AIN3)
unnamed: C85.1, C89.1, R114.1, U34.4 (AIN0)
unnamed: C86.1, C89.2, R115.1, U34.5 (AIN1)
unnamed: C87.1, C90.1, R116.1, U34.6 (AIN2)
unnamed: C88.1, C90.2, R117.1, U34.7 (AIN3)
unnamed: C92.1, C96.1, R122.1, U35.4 (AIN0)
unnamed: C93.1, C96.2, R123.1, U35.5 (AIN1)
unnamed: C94.1, C97.1, R124.1, U35.6 (AIN2)
unnamed: C95.1, C97.2, R125.1, U35.7 (AIN3)

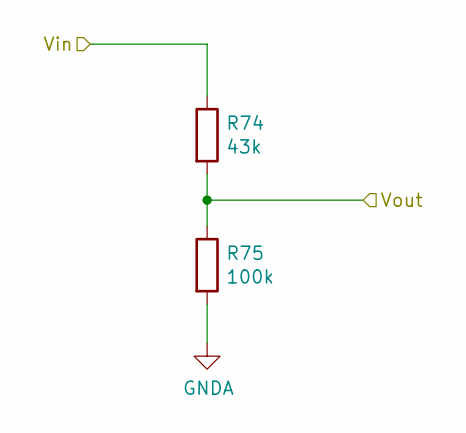
[picture p8: schematic VoltageIndiv.sch]

Parts:
R38: 43k; R_0805_2012Metric
R39: 100k; R_0805_2012Metric

Connections:
/A0: R38.2, R39.1; also elsewhere on the board
/VinPassif1: R38.1; also elsewhere on the board
GNDA: R39.2; also elsewhere on the board

Parts of its further copies:
R40, R42, R44, R46, R48, R50, R52, R66, R68, R70, R72, R74, R76, R78, R80: 43k; R_0805_2012Metric
R41, R43, R45, R47, R49, R51, R53, R67, R69, R71, R73, R75, R77, R79, R81: 100k; R_0805_2012Metric

Connections of its further copies:
/A1: R40.2, R41.1; also elsewhere on the board
/A2: R42.2, R43.1; also elsewhere on the board
/A3: R44.2, R45.1; also elsewhere on the board
/A4: R46.2, R47.1; also elsewhere on the board
/A5: R48.2, R49.1; also elsewhere on the board
/A6: R50.2, R51.1; also elsewhere on the board
/A7: R52.2, R53.1; also elsewhere on the board
/A8: R66.2, R67.1; also elsewhere on the board
/A9: R68.2, R69.1; also elsewhere on the board
/A10: R70.2, R71.1; also elsewhere on the board
/A11: R72.2, R73.1; also elsewhere on the board
/A12: R74.2, R75.1; also elsewhere on the board
/A13: R76.2, R77.1; also elsewhere on the board
/A14: R78.2, R79.1; also elsewhere on the board
/A15: R80.2, R81.1; also elsewhere on the board
/VinActif1: R66.1; also elsewhere on the board
/VinActif2: R68.1; also elsewhere on the board
/VinActif3: R70.1; also elsewhere on the board
/VinActif4: R72.1; also elsewhere on the board
/VinActif5: R74.1; also elsewhere on the board
/VinActif6: R76.1; also elsewhere on the board
/VinActif7: R78.1; also elsewhere on the board
/VinActif8: R80.1; also elsewhere on the board
/VinPassif2: R40.1; also elsewhere on the board
/VinPassif3: R42.1; also elsewhere on the board
/VinPassif4: R44.1; also elsewhere on the board
/VinPassif5: R46.1; also elsewhere on the board
/VinPassif6: R48.1; also elsewhere on the board
/VinPassif7: R50.1; also elsewhere on the board
/VinPassif8: R52.1; also elsewhere on the board
GNDA: R41.2, R43.2, R45.2, R47.2, R49.2, R51.2, R53.2, R67.2, R69.2, R71.2, R73.2, R75.2, R77.2, R79.2, R81.2; also elsewhere on the board

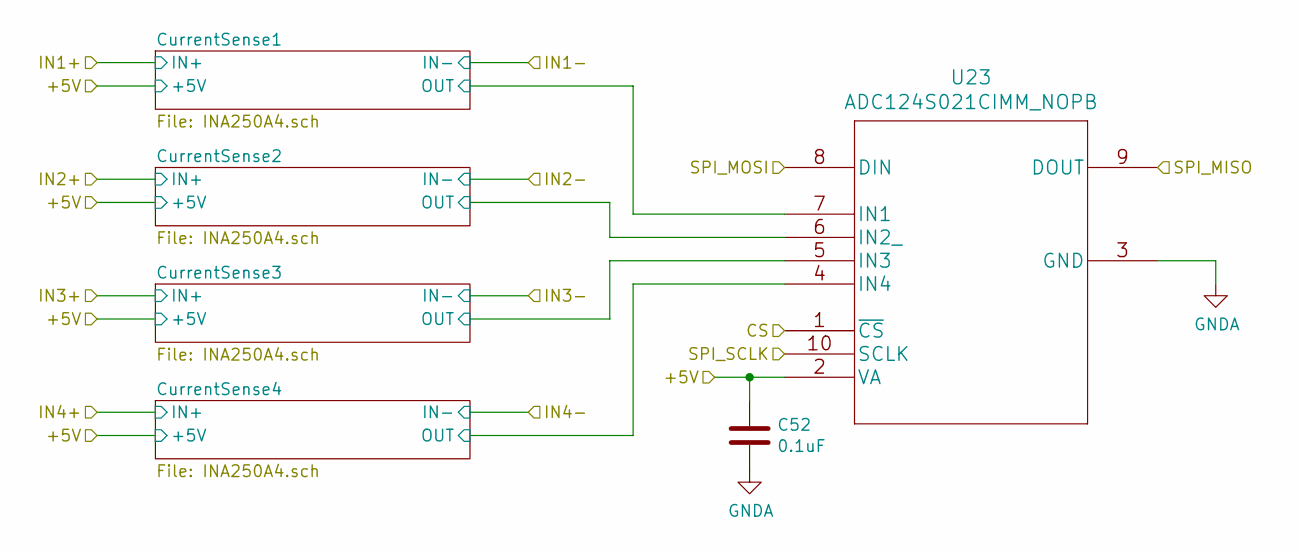
[picture p9: schematic CourantActif5W.sch]

Parts:
C52: 0.1uF; C_0402_1005Metric
U23: ADC124S021CIMM_NOPB; VSSOP-10_3x3mm_P0.5mm

Connections:
/+5V: C52.1, U23.2 (VA); also elsewhere on the board
/CS9: U23.1 (~CS); also elsewhere on the board
/CourantIndiv1/CurrentSense1/OUT: U23.7 (IN1); also elsewhere on the board
/CourantIndiv1/CurrentSense2/OUT: U23.6 (IN2_); also elsewhere on the board
/CourantIndiv1/CurrentSense3/OUT: U23.5 (IN3); also elsewhere on the board
/CourantIndiv1/CurrentSense4/OUT: U23.4 (IN4); also elsewhere on the board
/MISO: U23.9 (DOUT); also elsewhere on the board
/MOSI: U23.8 (DIN); also elsewhere on the board
/SCK: U23.10 (SCLK); also elsewhere on the board
GNDA: C52.2, U23.3 (GND); also elsewhere on the board

Parts of its further copies:
C37, C42, C47: 0.1uF; C_0402_1005Metric
U8, U13, U18: ADC124S021CIMM_NOPB; VSSOP-10_3x3mm_P0.5mm

Connections of its further copies:
/+5V: C37.1, C42.1, C47.1, U8.2 (VA), U13.2 (VA), U18.2 (VA); also elsewhere on the board
/CS10: U8.1 (~CS); also elsewhere on the board
/CS11: U13.1 (~CS); also elsewhere on the board
/CS12: U18.1 (~CS); also elsewhere on the board
/CourantActif5W1/CurrentSense1/OUT: U13.7 (IN1); also elsewhere on the board
/CourantActif5W1/CurrentSense2/OUT: U13.6 (IN2_); also elsewhere on the board
/CourantActif5W1/CurrentSense3/OUT: U13.5 (IN3); also elsewhere on the board
/CourantActif5W1/CurrentSense4/OUT: U13.4 (IN4); also elsewhere on the board
/CourantActif5W2/CurrentSense1/OUT: U18.7 (IN1); also elsewhere on the board
/CourantActif5W2/CurrentSense2/OUT: U18.6 (IN2_); also elsewhere on the board
/CourantActif5W2/CurrentSense3/OUT: U18.5 (IN3); also elsewhere on the board
/CourantActif5W2/CurrentSense4/OUT: U18.4 (IN4); also elsewhere on the board
/CourantIndiv2/CurrentSense1/OUT: U8.7 (IN1); also elsewhere on the board
/CourantIndiv2/CurrentSense2/OUT: U8.6 (IN2_); also elsewhere on the board
/CourantIndiv2/CurrentSense3/OUT: U8.5 (IN3); also elsewhere on the board
/CourantIndiv2/CurrentSense4/OUT: U8.4 (IN4); also elsewhere on the board
/MISO: U8.9 (DOUT), U13.9 (DOUT), U18.9 (DOUT); also elsewhere on the board
/MOSI: U8.8 (DIN), U13.8 (DIN), U18.8 (DIN); also elsewhere on the board
/SCK: U8.10 (SCLK), U13.10 (SCLK), U18.10 (SCLK); also elsewhere on the board
GNDA: C37.2, C42.2, C47.2, U8.3 (GND), U13.3 (GND), U18.3 (GND); also elsewhere on the board

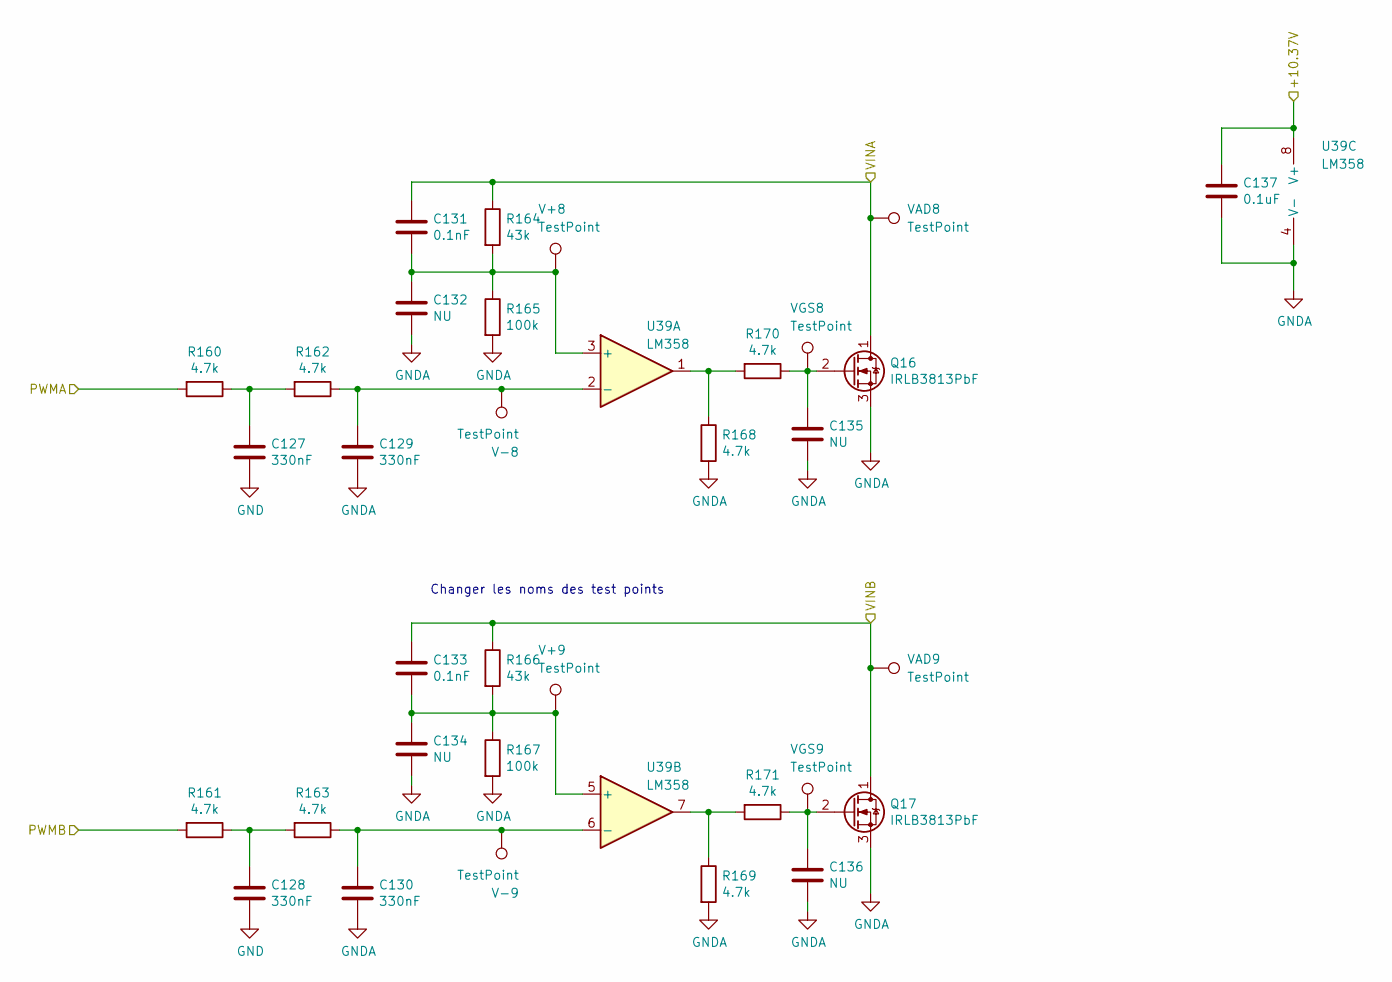
[picture p10: schematic ChargeActive5W.sch]

Parts:
C57, C58, C59, C60: 330nF; C_0603_1608Metric
C61, C63: 0.1nF; C_0402_1005Metric
C62, C64, C65, C66: NU; C_0402_1005Metric
C67: 0.1uF; C_0402_1005Metric
Q2, Q3: IRLB3813PbF; TO-220-3_Horizontal_TabDown_AccessHole
R54, R55, R56, R57, R62, R63, R64, R65: 4.7k; R_0805_2012Metric
R58, R60: 43k; R_0805_2012Metric
R59, R61: 100k; R_0805_2012Metric
U28: LM358; SOIC-8_3.9x4.9mm_P1.27mm
V+1, V+2: TestPoint; TestPoint_Pad_1.0x1.0mm
V-1, V-2: TestPoint; TestPoint_Pad_1.0x1.0mm
VAD1, VAD2: TestPoint; TestPoint_Pad_1.0x1.0mm
VGS1, VGS2: TestPoint; TestPoint_Pad_1.0x1.0mm

Connections:
/+10.37V: C67.2, U28.8 (V+); also elsewhere on the board
/PWM1: R54.2; also elsewhere on the board
/PWM2: R55.2; also elsewhere on the board
/VoutActif1: C61.2, Q2.1 (D), R58.1, VAD1.1; also elsewhere on the board
/VoutActif2: C63.2, Q3.1 (D), R60.1, VAD2.1; also elsewhere on the board
GND: C57.1, C58.1; also elsewhere on the board
GNDA: C59.1, C60.1, C62.1, C64.1, C65.1, C66.1, C67.1, Q2.3 (S), Q3.3 (S), R59.2, R61.2, R62.2, R63.2, U28.4 (V-); also elsewhere on the board
unnamed: C57.2, R54.1, R56.2
unnamed: C58.2, R55.1, R57.2
unnamed: C59.2, R56.1, U28.2 (-), V-1.1
unnamed: C60.2, R57.1, U28.6 (-), V-2.1
unnamed: C61.1, C62.2, R58.2, R59.1, U28.3 (+), V+1.1
unnamed: C63.1, C64.2, R60.2, R61.1, U28.5 (+), V+2.1
unnamed: C65.2, Q2.2 (G), R64.1, VGS1.1
unnamed: C66.2, Q3.2 (G), R65.1, VGS2.1
unnamed: R62.1, R64.2, U28.1
unnamed: R63.1, R65.2, U28.7

Parts of its further copies:
C105, C106, C107, C108, C116, C117, C118, C119, C127, C128, C129, C130: 330nF; C_0603_1608Metric
C109, C111, C120, C122, C131, C133: 0.1nF; C_0402_1005Metric
C110, C112, C113, C114, C121, C123, C124, C125, C132, C134, C135, C136: NU; C_0402_1005Metric
C115, C126, C137: 0.1uF; C_0402_1005Metric
Q12, Q13, Q14, Q15, Q16, Q17: IRLB3813PbF; TO-220-3_Horizontal_TabDown_AccessHole
R136, R137, R138, R139, R144, R145, R146, R147, R148, R149, R150, R151, R156, R157, R158, R159, R160, R161, R162, R163, R168, R169, R170, R171: 4.7k; R_0805_2012Metric
R140, R142, R152, R154, R164, R166: 43k; R_0805_2012Metric
R141, R143, R153, R155, R165, R167: 100k; R_0805_2012Metric
U37, U38, U39: LM358; SOIC-8_3.9x4.9mm_P1.27mm
V+4, V+5, V+6, V+7, V+8, V+9: TestPoint; TestPoint_Pad_1.0x1.0mm
V-4, V-5, V-6, V-7, V-8, V-9: TestPoint; TestPoint_Pad_1.0x1.0mm
VAD4, VAD5, VAD6, VAD7, VAD8, VAD9: TestPoint; TestPoint_Pad_1.0x1.0mm
VGS4, VGS5, VGS6, VGS7, VGS8, VGS9: TestPoint; TestPoint_Pad_1.0x1.0mm

Connections of its further copies:
/+10.37V: C115.2, C126.2, C137.2, U37.8 (V+), U38.8 (V+), U39.8 (V+); also elsewhere on the board
/PWM3: R136.2; also elsewhere on the board
/PWM4: R137.2; also elsewhere on the board
/PWM5: R148.2; also elsewhere on the board
/PWM6: R149.2; also elsewhere on the board
/PWM7: R160.2; also elsewhere on the board
/PWM8: R161.2; also elsewhere on the board
/VoutActif3: C109.2, Q12.1 (D), R140.1, VAD4.1; also elsewhere on the board
/VoutActif4: C111.2, Q13.1 (D), R142.1, VAD5.1; also elsewhere on the board
/VoutActif5: C120.2, Q14.1 (D), R152.1, VAD6.1; also elsewhere on the board
/VoutActif6: C122.2, Q15.1 (D), R154.1, VAD7.1; also elsewhere on the board
/VoutActif7: C131.2, Q16.1 (D), R164.1, VAD8.1; also elsewhere on the board
/VoutActif8: C133.2, Q17.1 (D), R166.1, VAD9.1; also elsewhere on the board
GND: C105.1, C106.1, C116.1, C117.1, C127.1, C128.1; also elsewhere on the board
GNDA: C107.1, C108.1, C110.1, C112.1, C113.1, C114.1, C115.1, C118.1, C119.1, C121.1, C123.1, C124.1, C125.1, C126.1, C129.1, C130.1, C132.1, C134.1, C135.1, C136.1, C137.1, Q12.3 (S), Q13.3 (S), Q14.3 (S), Q15.3 (S), Q16.3 (S), Q17.3 (S), R141.2, R143.2, R144.2, R145.2, R153.2, R155.2, R156.2, R157.2, R165.2, R167.2, R168.2, R169.2, U37.4 (V-), U38.4 (V-), U39.4 (V-); also elsewhere on the board
unnamed: C105.2, R136.1, R138.2
unnamed: C106.2, R137.1, R139.2
unnamed: C107.2, R138.1, U37.2 (-), V-4.1
unnamed: C108.2, R139.1, U37.6 (-), V-5.1
unnamed: C109.1, C110.2, R140.2, R141.1, U37.3 (+), V+4.1
unnamed: C111.1, C112.2, R142.2, R143.1, U37.5 (+), V+5.1
unnamed: C113.2, Q12.2 (G), R146.1, VGS4.1
unnamed: C114.2, Q13.2 (G), R147.1, VGS5.1
unnamed: C116.2, R148.1, R150.2
unnamed: C117.2, R149.1, R151.2
unnamed: C118.2, R150.1, U38.2 (-), V-6.1
unnamed: C119.2, R151.1, U38.6 (-), V-7.1
unnamed: C120.1, C121.2, R152.2, R153.1, U38.3 (+), V+6.1
unnamed: C122.1, C123.2, R154.2, R155.1, U38.5 (+), V+7.1
unnamed: C124.2, Q14.2 (G), R158.1, VGS6.1
unnamed: C125.2, Q15.2 (G), R159.1, VGS7.1
unnamed: C127.2, R160.1, R162.2
unnamed: C128.2, R161.1, R163.2
unnamed: C129.2, R162.1, U39.2 (-), V-8.1
unnamed: C130.2, R163.1, U39.6 (-), V-9.1
unnamed: C131.1, C132.2, R164.2, R165.1, U39.3 (+), V+8.1
unnamed: C133.1, C134.2, R166.2, R167.1, U39.5 (+), V+9.1
unnamed: C135.2, Q16.2 (G), R170.1, VGS8.1
unnamed: C136.2, Q17.2 (G), R171.1, VGS9.1
unnamed: R144.1, R146.2, U37.1
unnamed: R145.1, R147.2, U37.7
unnamed: R156.1, R158.2, U38.1
unnamed: R157.1, R159.2, U38.7
unnamed: R168.1, R170.2, U39.1
unnamed: R169.1, R171.2, U39.7

Notes on the sheet:
Changer les noms des test points

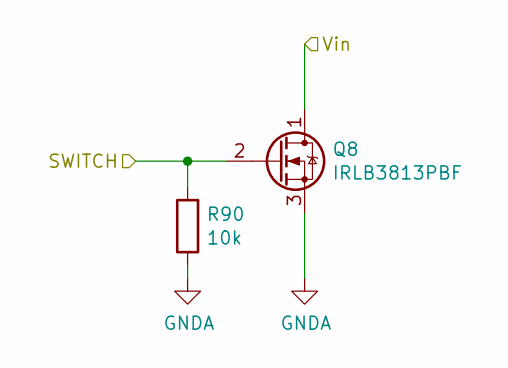
[picture p11: schematic ControleIndiv.sch]

Parts:
Q4: IRLB3813PBF; TO-220-3_Horizontal_TabDown_AccessHole
R82: 10k; R_0603_1608Metric

Connections:
/SW1: Q4.2 (G), R82.2; also elsewhere on the board
/VoutPassif1: Q4.1 (D); also elsewhere on the board
GNDA: Q4.3 (S), R82.1; also elsewhere on the board

Parts of its further copies:
Q5, Q6, Q7, Q8, Q9, Q10, Q11: IRLB3813PBF; TO-220-3_Horizontal_TabDown_AccessHole
R87, R88, R89, R90, R91, R92, R93: 10k; R_0603_1608Metric

Connections of its further copies:
/SW2: Q5.2 (G), R87.2; also elsewhere on the board
/SW3: Q6.2 (G), R88.2; also elsewhere on the board
/SW4: Q7.2 (G), R89.2; also elsewhere on the board
/SW5: Q8.2 (G), R90.2; also elsewhere on the board
/SW6: Q9.2 (G), R91.2; also elsewhere on the board
/SW7: Q10.2 (G), R92.2; also elsewhere on the board
/SW8: Q11.2 (G), R93.2; also elsewhere on the board
/VoutPassif2: Q5.1 (D); also elsewhere on the board
/VoutPassif3: Q6.1 (D); also elsewhere on the board
/VoutPassif4: Q7.1 (D); also elsewhere on the board
/VoutPassif5: Q8.1 (D); also elsewhere on the board
/VoutPassif6: Q9.1 (D); also elsewhere on the board
/VoutPassif7: Q10.1 (D); also elsewhere on the board
/VoutPassif8: Q11.1 (D); also elsewhere on the board
GNDA: Q5.3 (S), Q6.3 (S), Q7.3 (S), Q8.3 (S), Q9.3 (S), Q10.3 (S), Q11.3 (S), R87.1, R88.1, R89.1, R90.1, R91.1, R92.1, R93.1; also elsewhere on the board

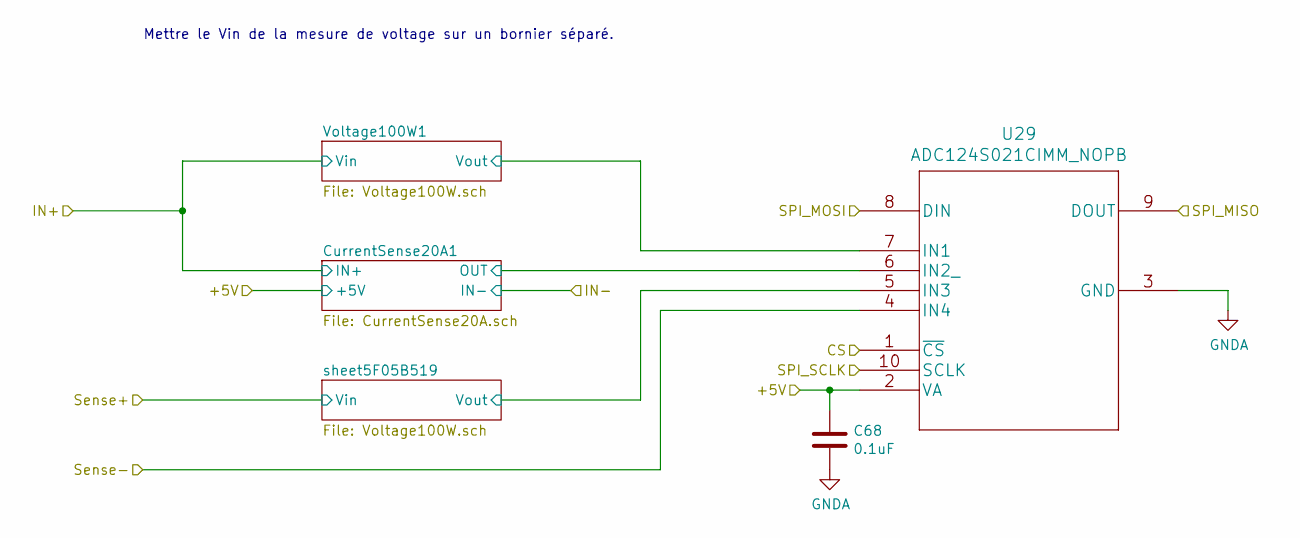
[picture p12: schematic Acquisition100W.sch]

Parts:
C68: 0.1uF; C_0402_1005Metric
U29: ADC124S021CIMM_NOPB; VSSOP-10_3x3mm_P0.5mm

Connections:
/+5V: C68.1, U29.2 (VA); also elsewhere on the board
/Acquisition100W/CurrentSense20A1/OUT: U29.6 (IN2_); also elsewhere on the board
/Acquisition100W/Voltage100W1/Vout: U29.7 (IN1); also elsewhere on the board
/Acquisition100W/sheet5F05B519/Vout: U29.5 (IN3); also elsewhere on the board
/CS13: U29.1 (~CS); also elsewhere on the board
/MISO: U29.9 (DOUT); also elsewhere on the board
/MOSI: U29.8 (DIN); also elsewhere on the board
/SCK: U29.10 (SCLK); also elsewhere on the board
/V-Sense100W: U29.4 (IN4); also elsewhere on the board
GNDA: C68.2, U29.3 (GND); also elsewhere on the board

Notes on the sheet:
Mettre le Vin de la mesure de voltage sur un bornier séparé.

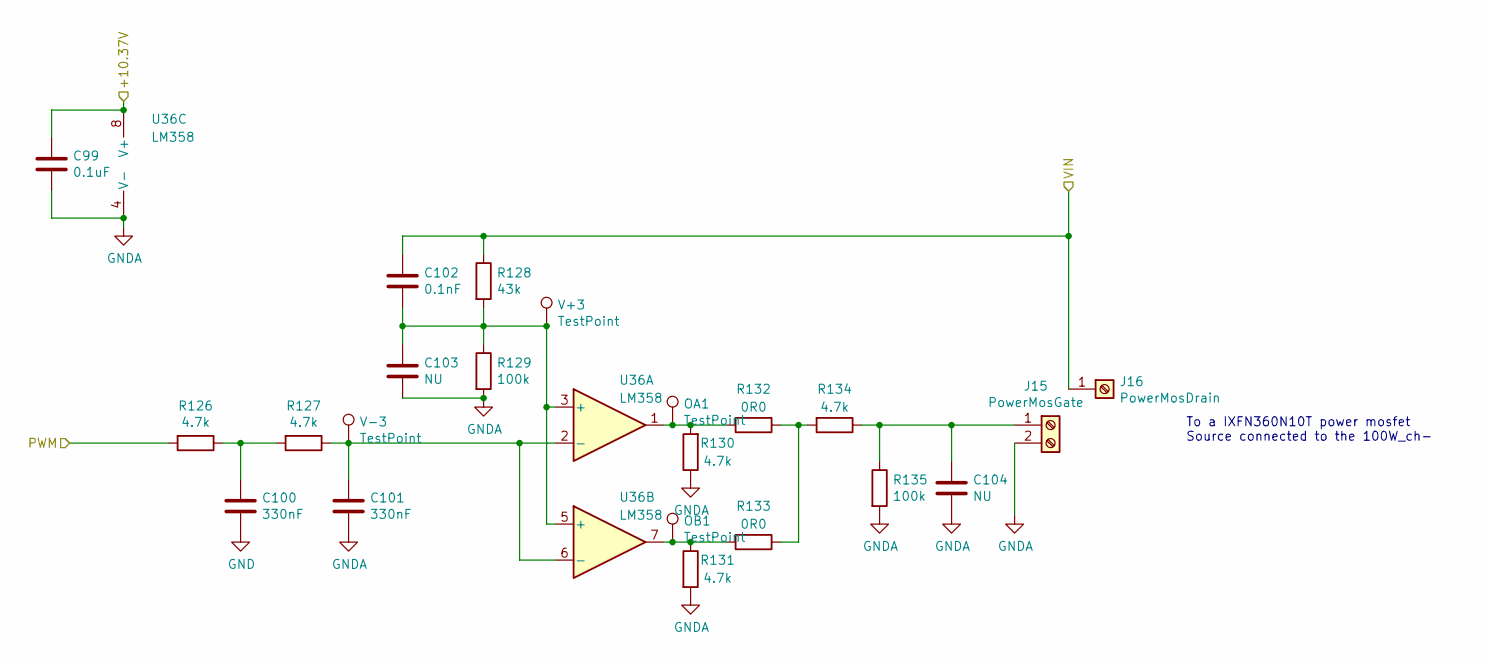
[picture p13: schematic ChargeActive100W.sch]

Parts:
C99: 0.1uF; C_0402_1005Metric
C100, C101: 330nF; C_0603_1608Metric
C102: 0.1nF; C_0402_1005Metric
C103, C104: NU; C_0402_1005Metric
J15: PowerMosGate; TerminalBlock_Phoenix_PT-1,5-2-5.0-H_1x02_P5.00mm_Horizontal
J16: PowerMosDrain; 30ATerminal
OA1: TestPoint; TestPoint_Pad_1.0x1.0mm
OB1: TestPoint; TestPoint_Pad_1.0x1.0mm
R126, R127, R130, R131, R134: 4.7k; R_0805_2012Metric
R128: 43k; R_0805_2012Metric
R129, R135: 100k; R_0805_2012Metric
R132, R133: 0R0; R_0805_2012Metric
U36: LM358; SOIC-8_3.9x4.9mm_P1.27mm
V+3: TestPoint; TestPoint_Pad_1.0x1.0mm
V-3: TestPoint; TestPoint_Pad_1.0x1.0mm

Connections:
/+10.37V: C99.2, U36.8 (V+); also elsewhere on the board
/PWM9: R126.2; also elsewhere on the board
/VoutActif100W: C102.2, J16.1, R128.1; also elsewhere on the board
GND: C100.1; also elsewhere on the board
GNDA: C99.1, C101.1, C103.1, C104.1, J15.2, R129.2, R130.1, R131.2, R135.2, U36.4 (V-); also elsewhere on the board
unnamed: C100.2, R126.1, R127.2
unnamed: C101.2, R127.1, U36.2 (-), U36.6 (-), V-3.1
unnamed: C102.1, C103.2, R128.2, R129.1, U36.3 (+), U36.5 (+), V+3.1
unnamed: C104.2, J15.1, R134.1, R135.1
unnamed: OA1.1, R130.2, R132.2, U36.1
unnamed: OB1.1, R131.1, R133.2, U36.7
unnamed: R132.1, R133.1, R134.2

Notes on the sheet:
To a IXFN360N10T power mosfet Source connected to the 100W_ch-

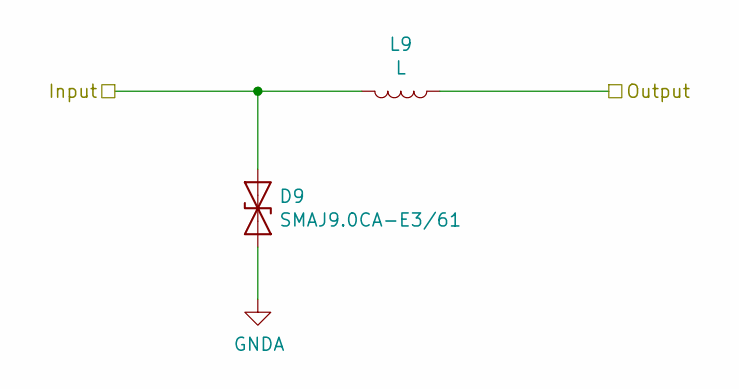
[picture p14: schematic ChanelProtection.sch]

Parts:
D2: SMAJ9.0CA-E3/61; D_SMA
L2: L; TraceInductor

Connections:
/AIProt1/Input: D2.1 (A1), L2.2; also elsewhere on the board
/VinPassif1: L2.1; also elsewhere on the board
GNDA: D2.2 (A2); also elsewhere on the board

Parts of its further copies:
D3, D4, D5, D6, D7, D8, D9, D10, D11, D12, D13, D14, D15, D16, D17, D18, D19: SMAJ9.0CA-E3/61; D_SMA
L3, L4, L5, L6, L7, L8, L9, L10, L11, L12, L13, L14, L15, L16, L17, L18, L19: L; TraceInductor

Connections of its further copies:
/AIProt2/Input: D3.1 (A1), L3.2; also elsewhere on the board
/AIProt3/Input: D4.1 (A1), L4.2; also elsewhere on the board
/AIProt4/Input: D5.1 (A1), L5.2; also elsewhere on the board
/AIProt5/Input: D6.1 (A1), L6.2; also elsewhere on the board
/AIProt6/Input: D7.1 (A1), L7.2; also elsewhere on the board
/AIProt7/Input: D8.1 (A1), L8.2; also elsewhere on the board
/AIProt8/Input: D9.1 (A1), L9.2; also elsewhere on the board
/ProtectionActif1/Input: D10.1 (A1), L10.2; also elsewhere on the board
/ProtectionActif2/Input: D11.1 (A1), L11.2; also elsewhere on the board
/ProtectionActif3/Input: D12.1 (A1), L12.2; also elsewhere on the board
/ProtectionActif4/Input: D13.1 (A1), L13.2; also elsewhere on the board
/ProtectionActif5/Input: D14.1 (A1), L14.2; also elsewhere on the board
/ProtectionActif6/Input: D15.1 (A1), L15.2; also elsewhere on the board
/ProtectionActif7/Input: D16.1 (A1), L16.2; also elsewhere on the board
/ProtectionActif8/Input: D17.1 (A1), L17.2; also elsewhere on the board
/SenseProtection+/Input: D18.1 (A1), L18.2; also elsewhere on the board
/SenseProtection-/Input: D19.1 (A1), L19.2; also elsewhere on the board
/V+Sense100W: L18.1; also elsewhere on the board
/V-Sense100W: L19.1; also elsewhere on the board
/VinActif1: L10.1; also elsewhere on the board
/VinActif2: L11.1; also elsewhere on the board
/VinActif3: L12.1; also elsewhere on the board
/VinActif4: L13.1; also elsewhere on the board
/VinActif5: L14.1; also elsewhere on the board
/VinActif6: L15.1; also elsewhere on the board
/VinActif7: L16.1; also elsewhere on the board
/VinActif8: L17.1; also elsewhere on the board
/VinPassif2: L3.1; also elsewhere on the board
/VinPassif3: L4.1; also elsewhere on the board
/VinPassif4: L5.1; also elsewhere on the board
/VinPassif5: L6.1; also elsewhere on the board
/VinPassif6: L7.1; also elsewhere on the board
/VinPassif7: L8.1; also elsewhere on the board
/VinPassif8: L9.1; also elsewhere on the board
GNDA: D3.2 (A2), D4.2 (A2), D5.2 (A2), D6.2 (A2), D7.2 (A2), D8.2 (A2), D9.2 (A2), D10.2 (A2), D11.2 (A2), D12.2 (A2), D13.2 (A2), D14.2 (A2), D15.2 (A2), D16.2 (A2), D17.2 (A2), D18.2 (A2), D19.2 (A2); also elsewhere on the board
