Philz69/3ITPCB/PCB.kicad_pcb

## KiCad design PCB.kicad_pcb (continued)

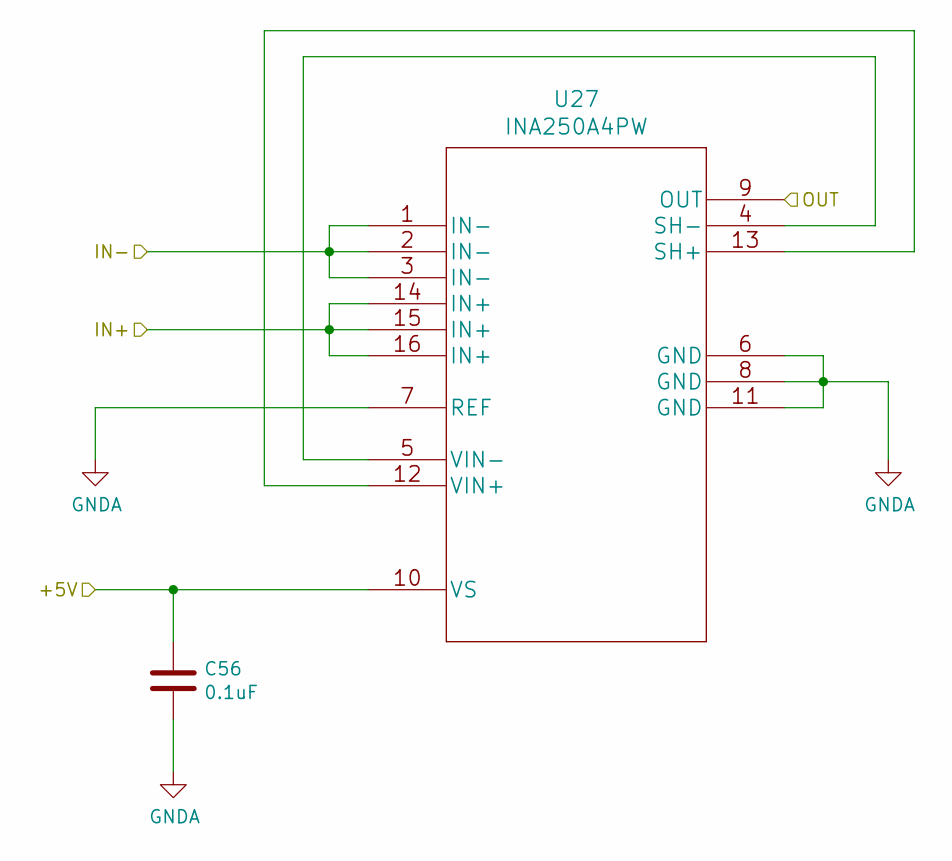
[picture p15: schematic INA250A4.sch]

Parts:
C56: 0.1uF; C_0402_1005Metric
U27: INA250A4PW; TSSOP-16_4.4x5mm_P0.65mm

Connections:
/+5V: C56.1, U27.10 (VS); also elsewhere on the board
/CourantIndiv1/CurrentSense1/OUT: U27.9 (OUT); also elsewhere on the board
/VinPassif1: U27.14 (IN+), U27.15 (IN+), U27.16 (IN+); also elsewhere on the board
/VoutPassif1: U27.1 (IN-), U27.2 (IN-), U27.3 (IN-); also elsewhere on the board
GNDA: C56.2, U27.6 (GND), U27.7 (REF), U27.8 (GND), U27.11 (GND); also elsewhere on the board
unnamed: U27.4 (SH-), U27.5 (VIN-)
unnamed: U27.12 (VIN+), U27.13 (SH+)

Parts of its further copies:
C38, C39, C40, C41, C43, C44, C45, C46, C48, C49, C50, C51, C53, C54, C55: 0.1uF; C_0402_1005Metric
U9, U10, U11, U12, U14, U15, U16, U17, U19, U20, U21, U22, U24, U25, U26: INA250A4PW; TSSOP-16_4.4x5mm_P0.65mm

Connections of its further copies:
/+5V: C38.1, C39.1, C40.1, C41.1, C43.1, C44.1, C45.1, C46.1, C48.1, C49.1, C50.1, C51.1, C53.1, C54.1, C55.1, U9.10 (VS), U10.10 (VS), U11.10 (VS), U12.10 (VS), U14.10 (VS), U15.10 (VS), U16.10 (VS), U17.10 (VS), U19.10 (VS), U20.10 (VS), U21.10 (VS), U22.10 (VS), U24.10 (VS), U25.10 (VS), U26.10 (VS); also elsewhere on the board
/CourantActif5W1/CurrentSense1/OUT: U17.9 (OUT); also elsewhere on the board
/CourantActif5W1/CurrentSense2/OUT: U14.9 (OUT); also elsewhere on the board
/CourantActif5W1/CurrentSense3/OUT: U15.9 (OUT); also elsewhere on the board
/CourantActif5W1/CurrentSense4/OUT: U16.9 (OUT); also elsewhere on the board
/CourantActif5W2/CurrentSense1/OUT: U22.9 (OUT); also elsewhere on the board
/CourantActif5W2/CurrentSense2/OUT: U19.9 (OUT); also elsewhere on the board
/CourantActif5W2/CurrentSense3/OUT: U20.9 (OUT); also elsewhere on the board
/CourantActif5W2/CurrentSense4/OUT: U21.9 (OUT); also elsewhere on the board
/CourantIndiv1/CurrentSense2/OUT: U24.9 (OUT); also elsewhere on the board
/CourantIndiv1/CurrentSense3/OUT: U25.9 (OUT); also elsewhere on the board
/CourantIndiv1/CurrentSense4/OUT: U26.9 (OUT); also elsewhere on the board
/CourantIndiv2/CurrentSense1/OUT: U12.9 (OUT); also elsewhere on the board
/CourantIndiv2/CurrentSense2/OUT: U9.9 (OUT); also elsewhere on the board
/CourantIndiv2/CurrentSense3/OUT: U10.9 (OUT); also elsewhere on the board
/CourantIndiv2/CurrentSense4/OUT: U11.9 (OUT); also elsewhere on the board
/VinActif1: U17.14 (IN+), U17.15 (IN+), U17.16 (IN+); also elsewhere on the board
/VinActif2: U14.14 (IN+), U14.15 (IN+), U14.16 (IN+); also elsewhere on the board
/VinActif3: U15.14 (IN+), U15.15 (IN+), U15.16 (IN+); also elsewhere on the board
/VinActif4: U16.14 (IN+), U16.15 (IN+), U16.16 (IN+); also elsewhere on the board
/VinActif5: U22.14 (IN+), U22.15 (IN+), U22.16 (IN+); also elsewhere on the board
/VinActif6: U19.14 (IN+), U19.15 (IN+), U19.16 (IN+); also elsewhere on the board
/VinActif7: U20.14 (IN+), U20.15 (IN+), U20.16 (IN+); also elsewhere on the board
/VinActif8: U21.14 (IN+), U21.15 (IN+), U21.16 (IN+); also elsewhere on the board
/VinPassif2: U24.14 (IN+), U24.15 (IN+), U24.16 (IN+); also elsewhere on the board
/VinPassif3: U25.14 (IN+), U25.15 (IN+), U25.16 (IN+); also elsewhere on the board
/VinPassif4: U26.14 (IN+), U26.15 (IN+), U26.16 (IN+); also elsewhere on the board
/VinPassif5: U12.14 (IN+), U12.15 (IN+), U12.16 (IN+); also elsewhere on the board
/VinPassif6: U9.14 (IN+), U9.15 (IN+), U9.16 (IN+); also elsewhere on the board
/VinPassif7: U10.14 (IN+), U10.15 (IN+), U10.16 (IN+); also elsewhere on the board
/VinPassif8: U11.14 (IN+), U11.15 (IN+), U11.16 (IN+); also elsewhere on the board
/VoutActif1: U17.1 (IN-), U17.2 (IN-), U17.3 (IN-); also elsewhere on the board
/VoutActif2: U14.1 (IN-), U14.2 (IN-), U14.3 (IN-); also elsewhere on the board
/VoutActif3: U15.1 (IN-), U15.2 (IN-), U15.3 (IN-); also elsewhere on the board
/VoutActif4: U16.1 (IN-), U16.2 (IN-), U16.3 (IN-); also elsewhere on the board
/VoutActif5: U22.1 (IN-), U22.2 (IN-), U22.3 (IN-); also elsewhere on the board
/VoutActif6: U19.1 (IN-), U19.2 (IN-), U19.3 (IN-); also elsewhere on the board
/VoutActif7: U20.1 (IN-), U20.2 (IN-), U20.3 (IN-); also elsewhere on the board
/VoutActif8: U21.1 (IN-), U21.2 (IN-), U21.3 (IN-); also elsewhere on the board
/VoutPassif2: U24.1 (IN-), U24.2 (IN-), U24.3 (IN-); also elsewhere on the board
/VoutPassif3: U25.1 (IN-), U25.2 (IN-), U25.3 (IN-); also elsewhere on the board
/VoutPassif4: U26.1 (IN-), U26.2 (IN-), U26.3 (IN-); also elsewhere on the board
/VoutPassif5: U12.1 (IN-), U12.2 (IN-), U12.3 (IN-); also elsewhere on the board
/VoutPassif6: U9.1 (IN-), U9.2 (IN-), U9.3 (IN-); also elsewhere on the board
/VoutPassif7: U10.1 (IN-), U10.2 (IN-), U10.3 (IN-); also elsewhere on the board
/VoutPassif8: U11.1 (IN-), U11.2 (IN-), U11.3 (IN-); also elsewhere on the board
GNDA: C38.2, C39.2, C40.2, C41.2, C43.2, C44.2, C45.2, C46.2, C48.2, C49.2, C50.2, C51.2, C53.2, C54.2, C55.2, U9.6 (GND), U9.7 (REF), U9.8 (GND), U9.11 (GND), U10.6 (GND), U10.7 (REF), U10.8 (GND), U10.11 (GND), U11.6 (GND), U11.7 (REF), U11.8 (GND), U11.11 (GND), U12.6 (GND), U12.7 (REF), U12.8 (GND), U12.11 (GND), U14.6 (GND), U14.7 (REF), U14.8 (GND), U14.11 (GND), U15.6 (GND), U15.7 (REF), U15.8 (GND), U15.11 (GND), U16.6 (GND), U16.7 (REF), U16.8 (GND), U16.11 (GND), U17.6 (GND), U17.7 (REF), U17.8 (GND), U17.11 (GND), U19.6 (GND), U19.7 (REF), U19.8 (GND), U19.11 (GND), U20.6 (GND), U20.7 (REF), U20.8 (GND), U20.11 (GND), U21.6 (GND), U21.7 (REF), U21.8 (GND), U21.11 (GND), U22.6 (GND), U22.7 (REF), U22.8 (GND), U22.11 (GND), U24.6 (GND), U24.7 (REF), U24.8 (GND), U24.11 (GND), U25.6 (GND), U25.7 (REF), U25.8 (GND), U25.11 (GND), U26.6 (GND), U26.7 (REF), U26.8 (GND), U26.11 (GND); also elsewhere on the board
unnamed: U9.4 (SH-), U9.5 (VIN-)
unnamed: U9.12 (VIN+), U9.13 (SH+)
unnamed: U10.4 (SH-), U10.5 (VIN-)
unnamed: U10.12 (VIN+), U10.13 (SH+)
unnamed: U11.4 (SH-), U11.5 (VIN-)
unnamed: U11.12 (VIN+), U11.13 (SH+)
unnamed: U12.4 (SH-), U12.5 (VIN-)
unnamed: U12.12 (VIN+), U12.13 (SH+)
unnamed: U14.4 (SH-), U14.5 (VIN-)
unnamed: U14.12 (VIN+), U14.13 (SH+)
unnamed: U15.4 (SH-), U15.5 (VIN-)
unnamed: U15.12 (VIN+), U15.13 (SH+)
unnamed: U16.4 (SH-), U16.5 (VIN-)
unnamed: U16.12 (VIN+), U16.13 (SH+)
unnamed: U17.4 (SH-), U17.5 (VIN-)
unnamed: U17.12 (VIN+), U17.13 (SH+)
unnamed: U19.4 (SH-), U19.5 (VIN-)
unnamed: U19.12 (VIN+), U19.13 (SH+)
unnamed: U20.4 (SH-), U20.5 (VIN-)
unnamed: U20.12 (VIN+), U20.13 (SH+)
unnamed: U21.4 (SH-), U21.5 (VIN-)
unnamed: U21.12 (VIN+), U21.13 (SH+)
unnamed: U22.4 (SH-), U22.5 (VIN-)
unnamed: U22.12 (VIN+), U22.13 (SH+)
unnamed: U24.4 (SH-), U24.5 (VIN-)
unnamed: U24.12 (VIN+), U24.13 (SH+)
unnamed: U25.4 (SH-), U25.5 (VIN-)
unnamed: U25.12 (VIN+), U25.13 (SH+)
unnamed: U26.4 (SH-), U26.5 (VIN-)
unnamed: U26.12 (VIN+), U26.13 (SH+)

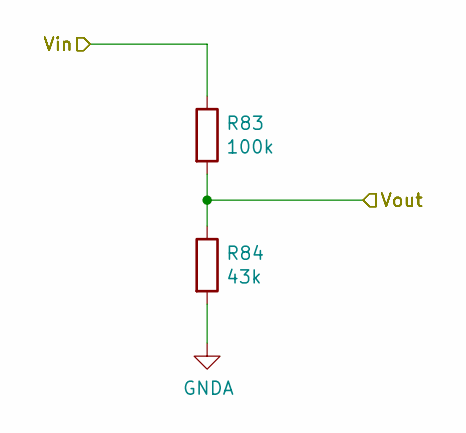
[picture p16: schematic Voltage100W.sch]

Parts:
R83: 100k; R_0805_2012Metric
R84: 43k; R_0805_2012Metric

Connections:
/Acquisition100W/Voltage100W1/Vout: R83.2, R84.1; also elsewhere on the board
/VinActif100W: R83.1; also elsewhere on the board
GNDA: R84.2; also elsewhere on the board

Parts of its further copies:
R85: 100k; R_0805_2012Metric
R86: 43k; R_0805_2012Metric

Connections of its further copies:
/Acquisition100W/sheet5F05B519/Vout: R85.2, R86.1; also elsewhere on the board
/V+Sense100W: R85.1; also elsewhere on the board
GNDA: R86.2; also elsewhere on the board

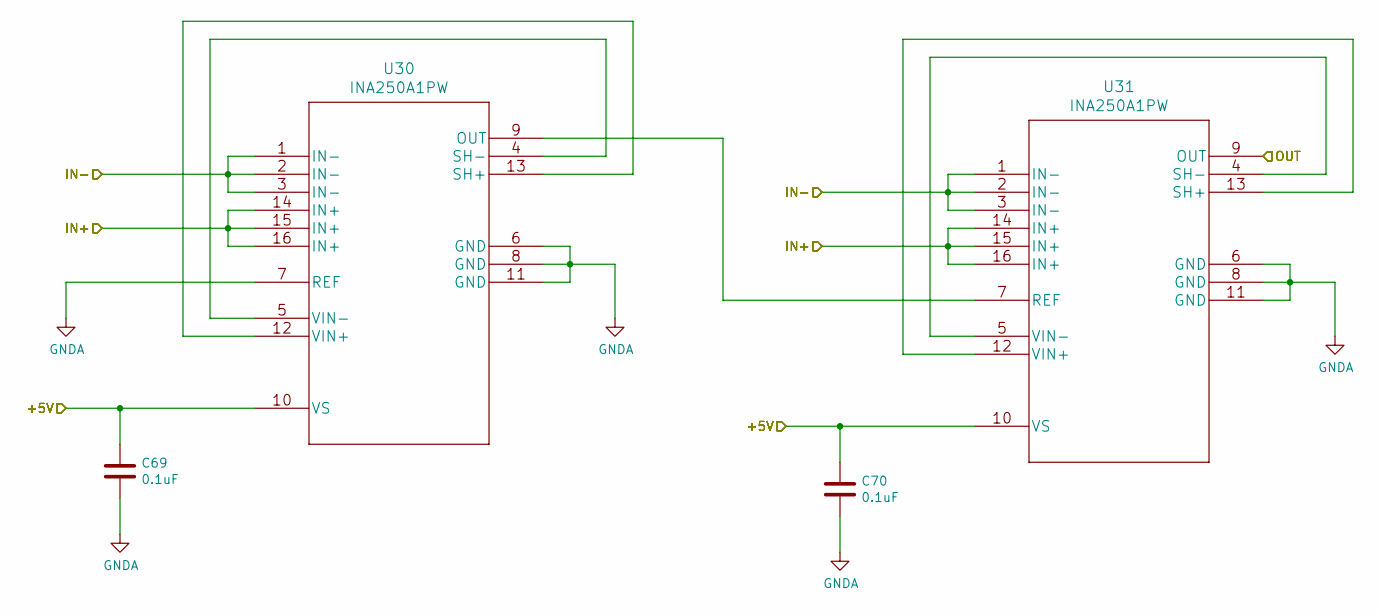
[picture p17: schematic CurrentSense20A.sch]

Parts:
C69, C70: 0.1uF; C_0402_1005Metric
U30, U31: INA250A1PW; TSSOP-16_4.4x5mm_P0.65mm

Connections:
/+5V: C69.1, C70.1, U30.10 (VS), U31.10 (VS); also elsewhere on the board
/Acquisition100W/CurrentSense20A1/OUT: U31.9 (OUT); also elsewhere on the board
/VinActif100W: U30.14 (IN+), U30.15 (IN+), U30.16 (IN+), U31.14 (IN+), U31.15 (IN+), U31.16 (IN+); also elsewhere on the board
/VoutActif100W: U30.1 (IN-), U30.2 (IN-), U30.3 (IN-), U31.1 (IN-), U31.2 (IN-), U31.3 (IN-); also elsewhere on the board
GNDA: C69.2, C70.2, U30.6 (GND), U30.7 (REF), U30.8 (GND), U30.11 (GND), U31.6 (GND), U31.8 (GND), U31.11 (GND); also elsewhere on the board
unnamed: U30.4 (SH-), U30.5 (VIN-)
unnamed: U30.9 (OUT), U31.7 (REF)
unnamed: U30.12 (VIN+), U30.13 (SH+)
unnamed: U31.4 (SH-), U31.5 (VIN-)
unnamed: U31.12 (VIN+), U31.13 (SH+)

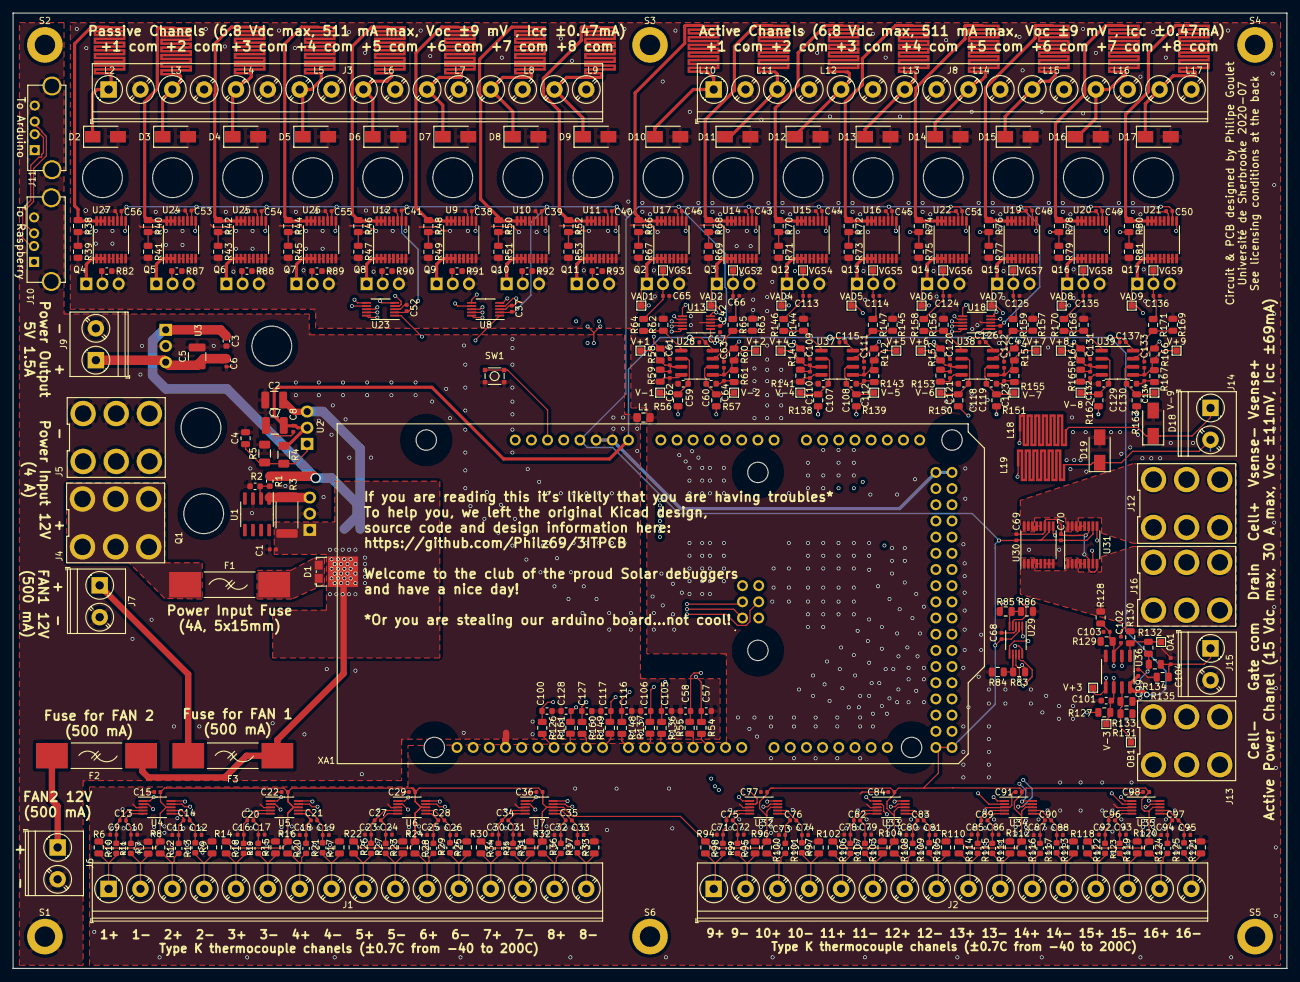
[picture p18: board PCB.kicad_pcb from above]

Board: 4 copper layers, 200.0 x 150.0 mm, 465 parts (0 on the bottom side), 286 nets.
