Philz69/3ITPCB/(commit log)

2020-06-18 commit initial
    [Acquisition100W.sch, ChanelProtection.sch, ChargeActive100W.sch, ChargeActive5W.sch, ControleIndiv.sch, CourantActif5W.sch, CourantIndiv.sch, CurrentSense20A.sch]
2020-06-18 Placement des cannaux de temperature
    [PCB.kicad_pcb]
2020-06-18 Placement canal passif intial
    [ChanelProtection.sch, ChargeActive5W.sch, ControleIndiv.sch, CourantActif5W.sch, INA250A4.sch, PCB.kicad_pcb, PCB.sch, VoltageIndiv.sch]
2020-06-18 Placement canal passif
    [PCB.kicad_pcb]
2020-06-18 Placement canal actif sauf charge active
    [PCB.kicad_pcb]
2020-06-18 Placement première charge active
    [ChanelProtection.sch, ChargeActive100W.sch, ChargeActive5W.sch, ControleIndiv.sch, CourantActif5W.sch, INA250A4.sch, PCB.kicad_pcb, VoltageIndiv.sch]
2020-06-18 Placement première charge active 2nd try
    [ChargeActive100W.sch, ChargeActive5W.sch, PCB.kicad_pcb, VoltageIndiv.sch]
2020-06-18 Placement première charge active, pret a dupliquer
    [PCB.kicad_pcb]
2020-06-18 Charge actives dupliques, placement filtres rc
    [PCB.kicad_pcb]
2020-06-18 Placement Charge active 100w et filtres PWM
    [PCB.kicad_pcb]
2020-06-19 Small modifications
    [PCB.kicad_pcb]
2020-06-19 Defi releve!
    [ChanelProtection.sch, ChargeActive100W.sch, ChargeActive5W.sch, PCB.kicad_pcb, PCB.sch, VoltageIndiv.sch]
2020-06-19 Essais de commiter tout les fichiers ce coup là
2020-06-20 Test placements
    [PCB.kicad_pcb]
2020-06-20 Placement current sensors avec pads
    [PCB.kicad_pcb]
2020-06-20 Placement charge active fini
    [PCB.kicad_pcb]
2020-06-20 Petit ajustement pour accomoder le usb du arduino, pret pour routing
    [ChanelProtection.sch, ChargeActive100W.sch, ChargeActive5W.sch, PCB.kicad_pcb, PCB.sch, Voltage100W.sch, VoltageIndiv.sch]
2020-06-20 Ajustement resistors température pour routing
    [PCB.kicad_pcb]
2020-06-23 Debug routing
    [ChargeActive5W.sch, ControleIndiv.sch, CourantActif5W.sch, INA250A4.sch, PCB.kicad_pcb, PCB.sch, VoltageIndiv.sch, temperature.sch]
2020-06-24 Routing initial température
    [PCB.kicad_pcb]
2020-06-24 retrait des test points inutiles
    [ChargeActive100W.sch, ChargeActive5W.sch, ControleIndiv.sch, INA250A4.sch, PCB.kicad_pcb, PCB.sch, Voltage100W.sch, VoltageIndiv.sch]
2020-06-24 routing temperature sauf chip select
    [PCB.kicad_pcb]
2020-06-24 routing 5V temperature + routing initial canal 100w
    [PCB.kicad_pcb]
2020-07-01 Routed most of the power
    [ChargeActive5W.sch, CourantActif5W.sch, PCB.kicad_pcb, PCB.sch, Voltage100W.sch, VoltageIndiv.sch, temperature.sch]
2020-07-01 More power routing
    [PCB.kicad_pcb]
2020-07-02 Routing power termine, premiere version
    [PCB.kicad_pcb]
2020-07-02 Ajout routing 5V manquant sur un dac
    [PCB.kicad_pcb]
2020-07-02 routing usb
    [ChanelProtection.sch, ChargeActive5W.sch, ControleIndiv.sch, CourantActif5W.sch, INA250A4.sch, PCB.kicad_pcb, PCB.sch, VoltageIndiv.sch]
2020-07-02 routing chip select temprature
    [PCB.kicad_pcb]
2020-07-03 derniere modifications
    [PCB.kicad_pcb]
2020-07-05 Debut rerouting power sur face arriere
    [PCB.kicad_pcb]
2020-07-05 Progres rerouting power
    [PCB.kicad_pcb]
2020-07-05 Debut routing cannaux passifs
    [ChargeActive100W.sch, ChargeActive5W.sch, ControleIndiv.sch, CourantActif5W.sch, INA250A4.sch, PCB.kicad_pcb, VoltageIndiv.sch]
2020-07-06 Routing canaux passif presque terminé
    [PCB.kicad_pcb]
2020-07-06 debut routing cannaux actifs
    [PCB.kicad_pcb]
2020-07-07 Ajustement placement canaux actifs
    [PCB.kicad_pcb, PCB.sch]
2020-07-07 Placement cannaux actifs + debut routing pwm
    [PCB.kicad_pcb]
2020-07-07 placement auto
    [PCB.kicad_pcb]
2020-07-07 Routing canaux actifs + routing PWM 1-8 termine
    [PCB.kicad_pcb]
2020-07-07 Routing PWM 9
    [PCB.kicad_pcb]
2020-07-07 Routing canaux actifs
    [PCB.kicad_pcb]
2020-07-08 simplification routing cannaux passifs
    [PCB.kicad_pcb]
2020-07-08 routing entree analogiques
    [PCB.kicad_pcb]
2020-07-08 Cleanup routing power + ajouts routing canal actif 100w
    [PCB.kicad_pcb]
2020-07-08 routing input canaux voltages
    [ChanelProtection.sch, ChargeActive100W.sch, ChargeActive5W.sch, ControleIndiv.sch, CourantActif5W.sch, INA250A4.sch, PCB.kicad_pcb, PCB.sch]
2020-07-08 Ajout premiers via pour ground
    [PCB.kicad_pcb]
2020-07-08 Ajout vias pour ground
    [PCB.kicad_pcb]
2020-07-09 Rerouting SPI pour canaux temperature
    [PCB.kicad_pcb]
2020-07-13 Changement pin pour switchs cannaux passifs
    [CourantActif5W.sch, INA250A4.sch, PCB.kicad_pcb, PCB.sch, temperature.sch]
2020-07-15 Added info on silkscreen layers, fixed DRC problems, added a license
    [PCB.kicad_pcb]
2020-07-17 Changement valeur de capaciteur + cleanup minime
    [PCB.csv, PCB.kicad_pcb, PCB.sch]
2020-07-22 Version Envoyée pour fabrication
    Modifications de certaines traces pour accomoder le fait que le fournisseur ne peut pas faire un board avec 0.2 mm de spacing en 2 Oz ... on élargit les traces et on places des ouvertures dans le solder mask pour permettre d'épaissir le métal avec de la soudure.
    [PCB-B_Cu.gbr, PCB-B_Mask.gbr, PCB-B_SilkS.gbr, PCB-Edge_Cuts.gbr, PCB-F_Cu.gbr, PCB-F_Mask.gbr, PCB-F_Paste.gbr, PCB-F_SilkS.gbr]
