Philz69/3ITPCB/(notices)

Notices in the files:
noname.kicad_pcb:
This work is licensed under the
Creative Commons Attribution-ShareAlike 4.0 International License.
http://creativecommons.org/licenses/by-sa/4.0
Creative Commons,
PO Box 1866,
